Aleksei327/ESP32-C5-OBD2-Scanner/README.md

# ESP32-C5 OBD2 Scanner

[Русская версия](README.ru.md)

A DIY dual-CAN OBD2 diagnostic adapter built on the Seeed XIAO ESP32-C5, together with a read-only Android app. The first target is my own Citroën C3 II (2011, 1.4 KFT): ECU list, fault codes (read and clear), live data, freeze frames, a bus monitor and a PDF report. Other cars are added through a JSON knowledge base, without changing the firmware.

> **Status (November 2026): working, tested on the car.** Board v1 is built into its OBD2 enclosure, the firmware and app 0.1.5 are finished for the C3 II, and the whole chain has been used on the car: on 2 and 3 November full scans found 10 ECUs, fault codes were read with their texts, live data and an A/C test were recorded. Release: [v1.0](https://github.com/Aleksei327/ESP32-C5-OBD2-Scanner/releases/tag/v1.0).

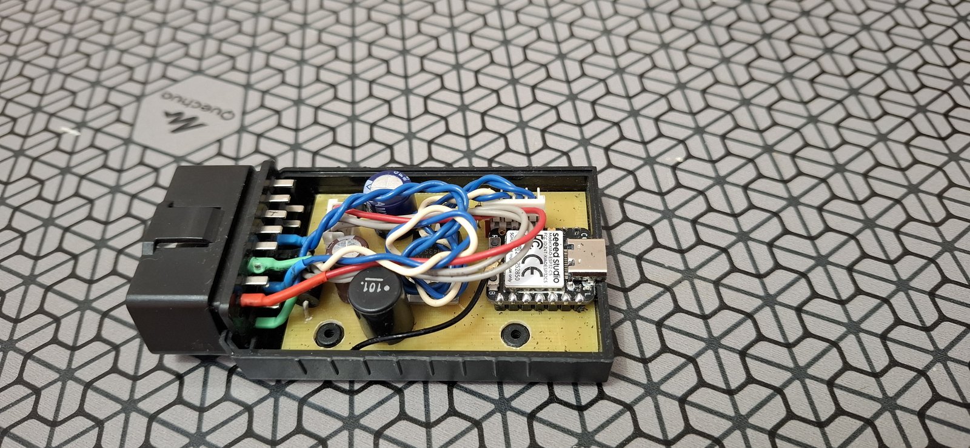
[picture p1: DOCS/images/photo-assembled.jpg]
The scanner in its OBD2 enclosure


## What works

- **Hardware:** single-sided 40 × 60 mm home-etched board in an OBD2 enclosure. Measured: on the car's OBD socket 13.4 V engine off and 14.4 V running; on the bench 4.95 V after the LM2596 and 4.83 V at the XIAO. The battery voltage reads within 0.05 V. Both CAN channels pass the self-test; the transmitters stay off in hardware until the firmware enables them.
- **Firmware** (ESP-IDF 6.1): Wi-Fi access point with its own password, WebSocket protocol, both CAN channels (OBD 6/14 and 3/8), ISO-TP with the PSA "response pending" handled, bus monitor, battery voltage, USB console with a self-test.
- **App 0.1.5** (Android): auto scan of every ECU in the knowledge base; ECU model recognised by part number; fault codes with texts from PSA-RE, the generic SAE list and, if built locally, the PSA code list in Russian and English; fault clearing; identification, live data, settings (read only); gauges, numbers and charts; bus monitor; PDF report. Scans are saved on the phone with a history (10 per car), a single module can be rescanned, and the garage and saved scans open without the adapter. The phone keeps its mobile internet while on the adapter's Wi-Fi.
- **Remote work:** a computer at home reaches the adapter at the car through the phone and a Cloudflare tunnel; `remote/scan.py` writes a full read-only scan to a report.
- **Simulator:** a C3 II in Python, to develop and test the app without the car.

Next: CAN-FD transceivers in board v2, and more cars through the knowledge base.

## The app

| | | |
| --- | --- | --- |
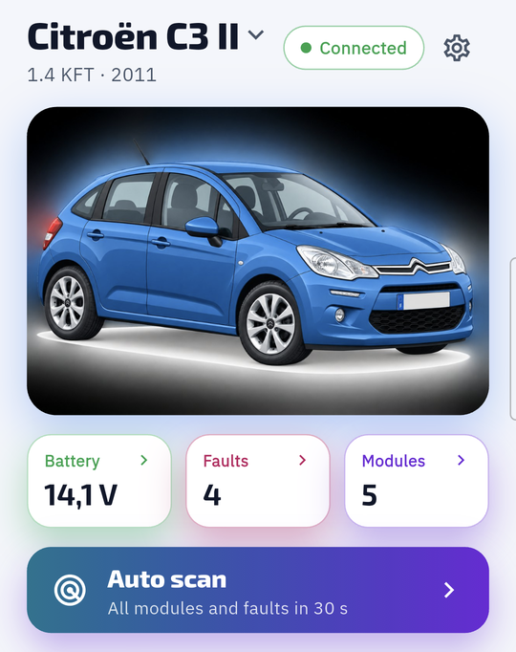
[picture p2: DOCS/images/app-car.png]
Car screen
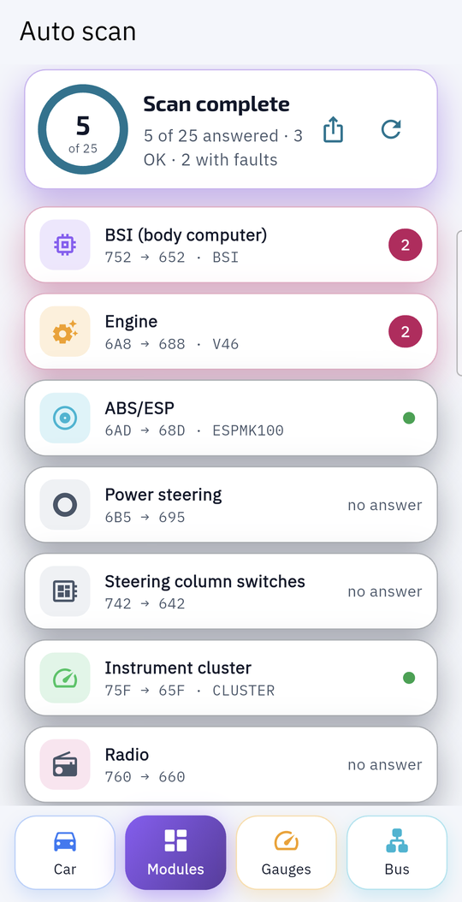
[picture p3: DOCS/images/app-scan.png]
Auto scan
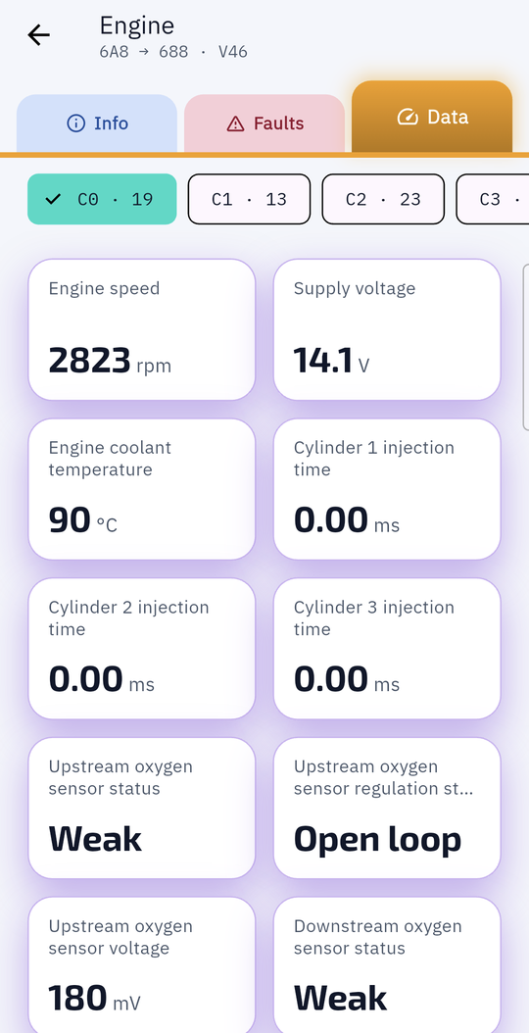
[picture p4: DOCS/images/app-live-data.png]
Engine live data
|  |  |  |
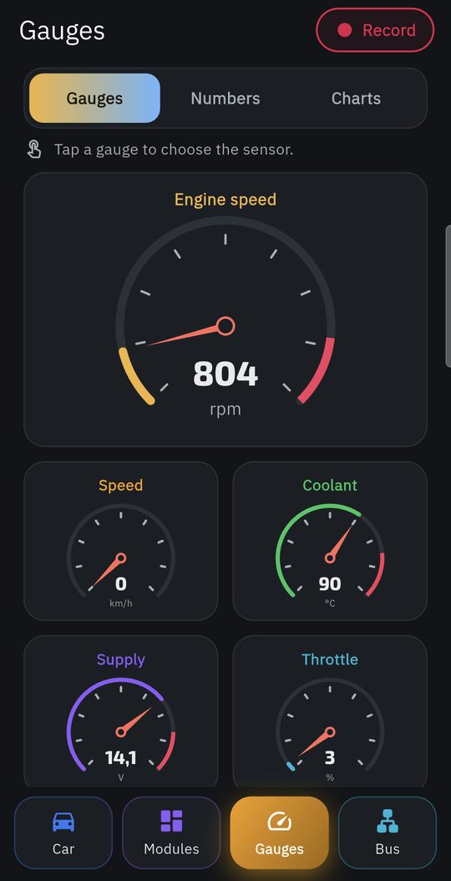
[picture p5: DOCS/images/app-gauges-dark.png]
Gauges, dark theme
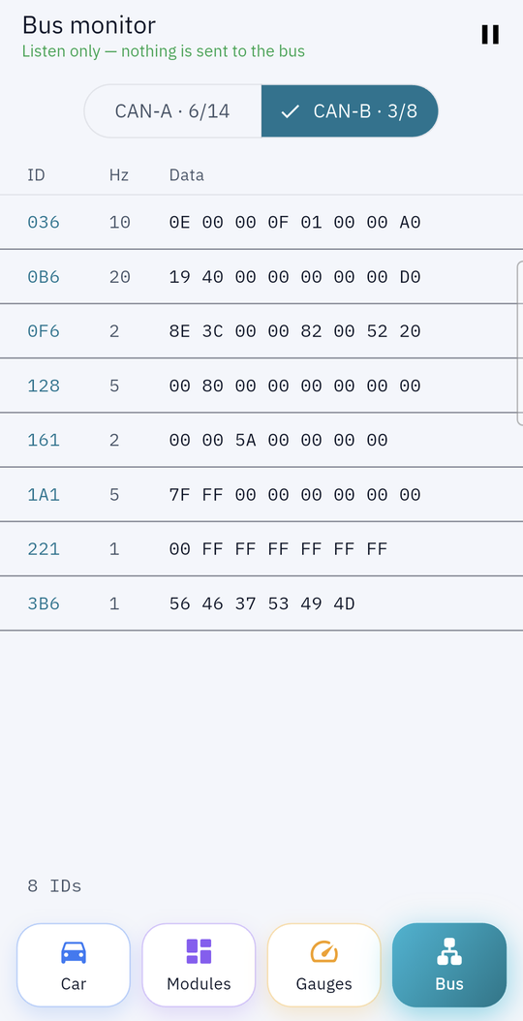
[picture p6: DOCS/images/app-bus-monitor.png]
Bus monitor
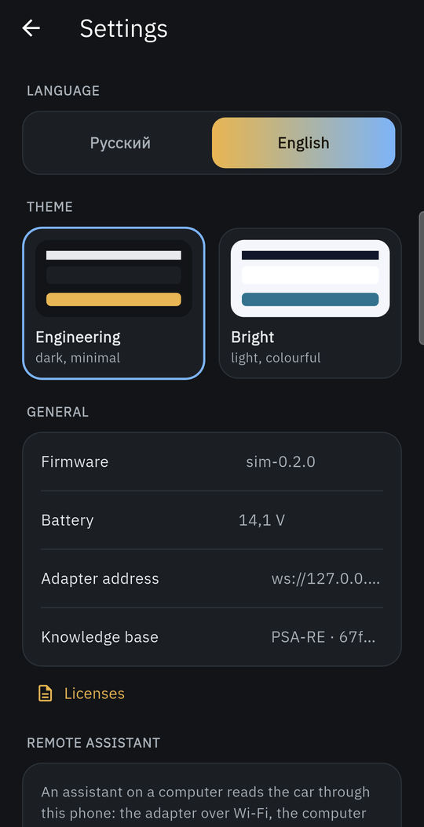
[picture p7: DOCS/images/app-settings-dark.png]
Settings, dark theme
|  |  |  |

App 0.1.3 in English. For these screenshots it is connected to the adapter simulator ([`sim/`](sim/README.md)), not to the car, so the ECUs and values are simulated.

## The board

| | | |
| --- | --- | --- |
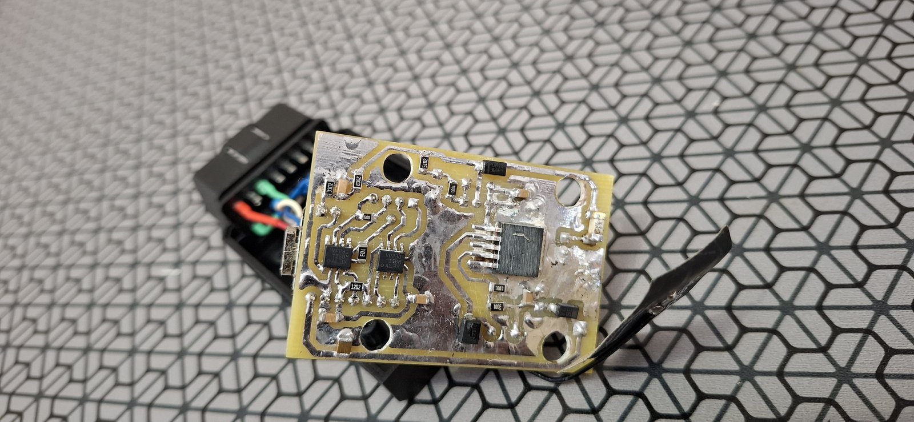
[picture p8: DOCS/images/photo-copper.jpg]
Copper side, home-etched and tinned
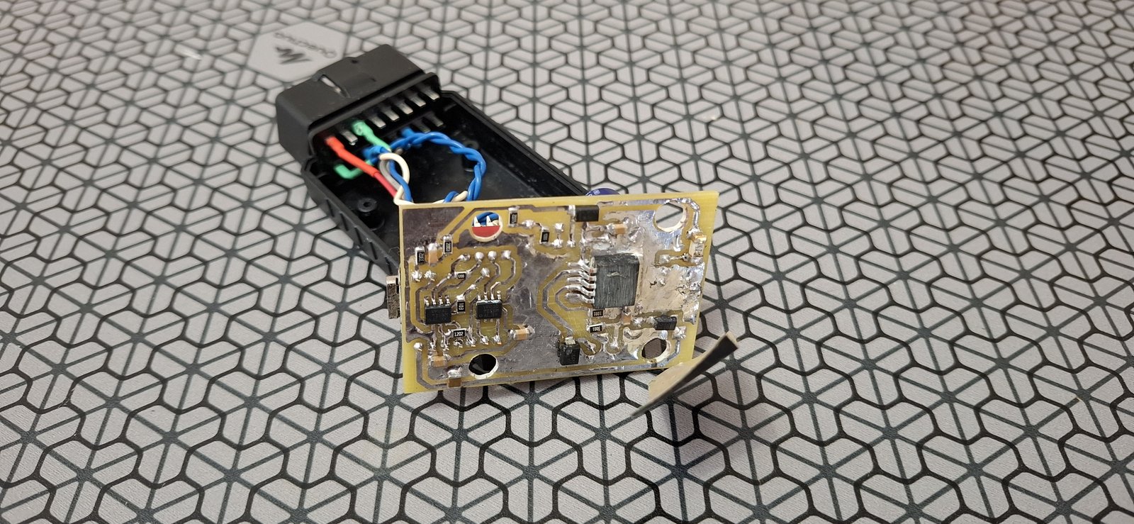
[picture p9: DOCS/images/photo-copper-angle.jpg]
Copper side at an angle
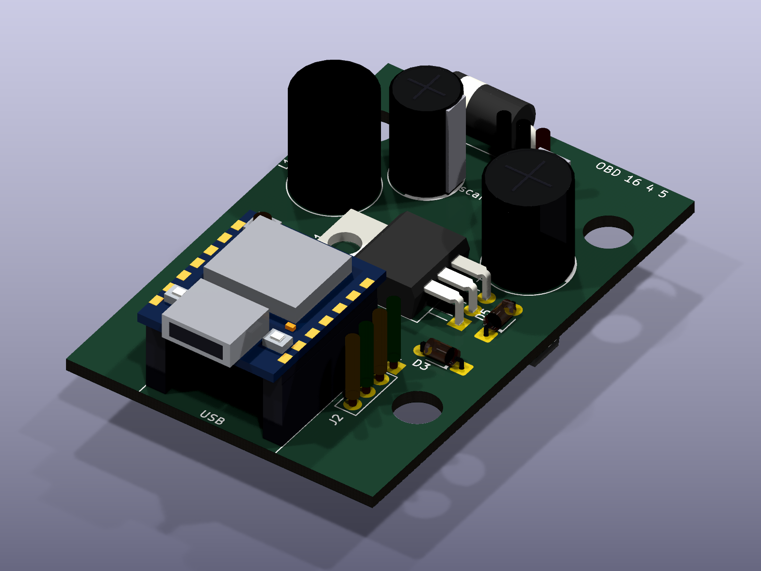
[picture p10: DOCS/images/board-3d-front.png]
Board v1, 3D view
|  |  |  |

The real board from the copper side (two SN65HVD230, the LM2596 and the SMD parts are on this side) and the KiCad 3D view of the component side. Schematic and layout: [`hardware/scaner_v1/`](hardware/scaner_v1/README.md).

## Key decisions

| What | Choice | Why |
| --- | --- | --- |
| MCU | Seeed XIAO ESP32-C5 | two CAN (TWAI) controllers, both CAN-FD capable; Wi-Fi 6 on 2.4 and 5 GHz; BLE; 8 MB PSRAM |
| CAN channel A | OBD 6/14 | legislated OBD-II (engine) |
| CAN channel B | OBD 3/8 | PSA Diag-on-CAN through the BSI, access to every ECU |
| Transceivers | 2 × SN65HVD230 (SOIC-8), desoldered from Waveshare modules | 3.3 V, enough for the C3; Rs on D9/D5 with pull-ups gives a hardware listen-only mode. CAN-FD transceivers in v2 |
| Power | OBD 16 → fuse → HS1M → IRFB4110 source follower (≤ 27 V) → LM2596S-ADJ (4.9 V) → SS34 (+ 1.5KE6.8CA TVS) → 3.3 V LDO on the XIAO | all from parts in stock; survives a 24 V jump start and surges up to 100 V |
| Hardware | own single-sided 40 × 60 mm board inside an OBD2 enclosure with a built-in connector; tracks on the bottom only, no jumpers | one dongle, no cables |
| App | Flutter for Android (Galaxy A55): read-only plus fault-code clearing; two themes; Russian and English | |
| Link | Wi-Fi, JSON over WebSocket; the adapter is a "dumb" transport, all logic lives in the app | a new car is a new JSON file |

## Repository

| Folder | Contents |
| --- | --- |
| [`hardware/scaner_v1/`](hardware/scaner_v1/README.md) | KiCad 10 project: schematic, PCB, footprints, 3D models, and the Python scripts that generate and route the board; PDF exports in `build/` |
| [`firmware/scaner_fw/`](firmware/scaner_fw/README.md) | ESP-IDF 6.1 adapter firmware: Wi-Fi access point and WebSocket server for the app, both CAN channels, battery voltage |
| [`app/`](app/README.md) | Flutter app |
| [`sim/`](sim/README.md) | Python simulator of the adapter with a C3 attached, to develop the app without hardware or a car |
| [`remote/`](remote/README.md) | remote assistant: a computer at home works with the adapter at the car through the phone and a Cloudflare tunnel |
| [`DOCS/en/`](DOCS/en/) | documentation in English ([`DOCS/`](DOCS/) — Russian originals) |

## Documentation

- [Board v1](DOCS/en/board-v1.md): block diagram, enclosure, OBD wiring, pin assignment, layout notes, first power-up
- [Input protection](DOCS/en/power-protection.md): what the car's electrical system does to pin 16 and how the board survives it
- [LM2596 DC-DC](DOCS/en/dc-dc-5v.md): parts and values
- [XIAO ESP32-C5](DOCS/en/xiao-esp32c5.md): pinout and which pins are used
- [SN65HVD230 transceiver](DOCS/en/can-sn65hvd230.md): wiring, listen-only mode, terminators
- [Adapter ↔ app protocol](DOCS/en/protocol.md)
- [Parts list](DOCS/en/parts-list.md)

PDF exports: [schematic](hardware/scaner_v1/build/scaner_v1.pdf), [placement and copper](hardware/scaner_v1/build/pcb_placement.pdf), [bottom copper 1:1 for etching](hardware/scaner_v1/build/pcb_bottom_cu.pdf).

## What is known about the C3 (PSA, AEE2004/2010 architecture)

- Full diagnostics run on pins **3/8** (Diag-on-CAN, 500 kbit/s) through the BSI. Pins **6/14** only give legislated engine OBD-II.
- Protocols: PSA-style KWP2000 (almost every ECU of the C3 II) and UDS, both over CAN (ISO-TP). The app finds out by itself which one an ECU speaks and recognises the ECU model by its part number.
- ECU addresses (request:response): BSI `752:652`, engine `6A8:688`, ABS/ESP `6AD:68D`, airbag `744:644`, instrument cluster `75F:65F`.
- On our C3 II 1.4 KFT the engine ECU is a Valeo V34 (KWP, session `81`). Answering: BSI, engine, ABS MK70, power steering, steering-column switches, instrument cluster, display, radio, airbag, seat-belt indicator and the battery sensor (the last one often answers "busy" or stays silent).
- Terminators: pins 6–14 already have both in the car (57 Ω), pins 3–8 only the BSI one (128 Ω), so the board has R8 fitted and R7 left out.

## Rules

1. The app only reads. The only write is clearing fault codes.
2. Airbag and ABS: read only. Emissions systems are not touched.
3. The adapter is not left in the car: pin 16 is powered from the battery at all times.

## Credits and third-party work

No third-party code is copied into this repository. The app's knowledge base is generated from PSA-RE data, with extra fault-code texts from ludwig-v and OBD Codes List (see below). These projects, tools and libraries were used or consulted:

- [prototux/PSA-RE](https://github.com/prototux/PSA-RE) (Apache-2.0) — PSA electronics reverse engineering: which ECUs the C3 II has, their addresses, protocols, part numbers, data records and fault-code texts. The app's knowledge base ([`app/assets/kb/`](app/assets/kb/)) is built from it by [`app/tool/build_kb.py`](app/tool/build_kb.py); its licence text ships with the data.
- [ludwig-v/arduino-psa-diag](https://github.com/ludwig-v/arduino-psa-diag) (GPL-3.0) — PSA ECU addresses ([ECU_LIST.md](https://github.com/ludwig-v/arduino-psa-diag/blob/master/ECU_LIST.md)) and KWP/UDS commands, used as a cross-check. Its fault-code lists fill the codes PSA-RE has no text for (mostly the BSI); they ship as a separate data file under GPL-3.0, [`app/assets/kb/c3_ii_dtc_gpl.json`](app/assets/kb/c3_ii_dtc_gpl.json), with the licence text next to it.
- [OBD Codes List](https://obdcodeslist.com/code-data.html) via [tekseport/obd2-codes](https://github.com/tekseport/obd2-codes) — generic SAE J2012 fault-code texts, shown when an ECU's own list has no text for a code. Code data from OBD Codes List, https://obdcodeslist.com/code-data.html
- [KiCad](https://www.kicad.org/) and its official symbol, footprint and 3D-model libraries.
- [Freerouting](https://github.com/freerouting/freerouting) — used to explore routing (`hardware/scaner_v1/tools/route.py`); the final layout is routed by hand.
- [ESP-IDF](https://github.com/espressif/esp-idf) (Espressif) — firmware framework; [Seeed Studio wiki](https://wiki.seeedstudio.com/xiao_esp32c5_getting_started/) — XIAO ESP32-C5 pinout.
- [Flutter](https://flutter.dev/) and the Dart packages listed in [`app/pubspec.yaml`](app/pubspec.yaml): web_socket_channel, flutter_svg, google_fonts, shared_preferences, intl, image_picker, path_provider, pdf, share_plus.
- Fonts [Exo 2](https://fonts.google.com/specimen/Exo+2) and [IBM Plex](https://github.com/IBM/plex), SIL Open Font License 1.1 (licence texts in `app/assets/google_fonts/`).
- [websockets](https://github.com/python-websockets/websockets) — the simulator's WebSocket server.
- Datasheets and application data: Texas Instruments (SN65HVD230, LM2596), Espressif (ESP32-C5), Waveshare (SN65HVD230 CAN Board schematic).

Each of these keeps its own licence.

## License

See [NOTICE.md](NOTICE.md) and [LICENSE](LICENSE) (CC BY-NC-ND 4.0, with permission to build one unit for yourself).
