Aleksei327/ESP32-C5-OBD2-Scanner/DOCS/ПЛАТА_v1.md

# Плата v1

**Цель:** первая своя плата, на которой собрано всё, внутри корпуса OBD2 с разъёмом. Подключаем её к C3, читаем стандартный OBD-II (канал A) и опознаём BSI через Diag-on-CAN (канал B).

[English version](en/board-v1.md)

Компоненты: [плата XIAO ESP32-C5](ESP32-C5_ПЛАТА.md), [трансивер SN65HVD230](CAN_SN65HVD230.md), [DC-DC на LM2596](DC-DC_5V.md), [защита питания](ЗАЩИТА_ПИТАНИЯ.md). KiCad-проект — [hardware/scaner_v1](../hardware/scaner_v1/).

## Блок-схема

```text
OBD 16 ─► предохранитель ─► HS1M ─► повторитель IRFB4110 (≤ 27 В) ─► LM2596S-ADJ (4,9 В) ─► SS34 ─► 5V (TVS 1.5KE6.8CA) ─► плата XIAO ESP32-C5 (LDO) ─► 3,3 В ─► VCC трансиверов
OBD 6/14 ─► SN65HVD230 (A) ◄─► D8 (GPIO8) D, D7 (GPIO12) R, D9 (GPIO9) Rs
OBD 3/8  ─► SN65HVD230 (B) ◄─► D1 (GPIO0) D, D10 (GPIO10) R, D5 (GPIO24) Rs
OBD 4, 5 ─► GND
```

Микросхемы SN65HVD230 выпаиваем с модулей Waveshare и ставим прямо на плату. XIAO — на гнёзда (модуль на ~10 мм над платой), а если по высоте не влезет, впаять напрямую. Защита питания и DC-DC собираются на плате.

## Корпус и размеры

Корпус OBD2 с встроенным разъёмом (AliExpress, ~10 €). По фото продавца: снаружи 72 × 45 мм, внутри шириной 42 мм, четыре стойки под винты 35 × 40 мм между центрами.

- Плата 40 × 60 мм, как собрана, подогнана по настоящему корпусу: четыре отверстия Ø5,5 мм над стойками под винты, между центрами 30,8 мм поперёк и 35,6 мм вдоль; первая пара в 9,55 мм от края у разъёма.
- Плата односторонняя, как в БП: нижняя медь — травленые дорожки, верхняя — перемычки из провода.
- От выводов разъёма к площадкам — проводки (нужны только 3, 4, 5, 6, 8, 14, 16). Питание (16, 4, 5) идёт на J1 у предохранителя, а обе пары CAN — на J2 у трансиверов: 14, 6, 8, 3 (провода по 4–5 см, пары лучше свить). Так через плату не тянется шина из четырёх дорожек.
- IRFB4110 (TO-220) лежит теплоотводом вниз над LM2596, без винта. TVS 1.5KE (DO-201AD, шаг 12,7 мм) и стеклянные стабилитроны (DO-35, корпус 3,5 × 1,9 мм, шаг 5,08 мм) — лёжа. Электролиты (C1 10 мм, C3 8 мм, оба высотой 12,3 мм) стоят: они не выше XIAO на гнёздах (~13 мм). C1 — впритык к стойке корпуса Ø8, зазор ~0,5 мм.
- XIAO стоит USB-разъёмом к дальнему торцу: можно прорезать окно в корпусе для прошивки без разборки.

> ⚠ Размеры взяты с фото продавца. Когда корпус придёт, обмерить: внутреннюю длину от разъёма до торца, положение стоек относительно разъёма, высоту внутри. Обвод платы и отверстия поправим под факт.

## Разъём OBD-II

| Пин OBD | Сигнал | Площадка |
| --- | --- | --- |
| 16 | +12 В от АКБ (есть всегда, даже без зажигания) | J1.1 |
| 4 | масса кузова | J1.2 |
| 5 | сигнальная масса | J1.3 |
| 14 | CAN-L, стандартный OBD-II (канал A) | J2.1 |
| 6 | CAN-H, стандартный OBD-II (канал A) | J2.2 |
| 8 | Diag CAN-L, PSA (канал B) | J2.3 |
| 3 | Diag CAN-H, PSA (канал B) | J2.4 |

На шелкографии подписано: «OBD 16 4 5» справа от J1 (слева направо) и номер вывода OBD под каждым пятаком J2: 14, 6, 8, 3.

Остальные пины не подключаем. После пайки всё прозвонить тестером: на штекере нумерация зеркальна гнезду машины.

## Питание

OBD 16 → предохранитель T2A (SMD Nano², снизу у J1) → HS1M → повторитель на IRFB4110 (на выходе не больше ~27 В) → 100 мкФ / 63 В → LM2596S-ADJ (4,9 В) → SS34 → линия 5V (на ней TVS 1.5KE6.8CA) → плата XIAO ESP32-C5. Её стабилизатор даёт 3,3 В, от них же питаются трансиверы. Подробно — в [ЗАЩИТА_ПИТАНИЯ](ЗАЩИТА_ПИТАНИЯ.md) и [DC-DC_5V](DC-DC_5V.md).

**SS34 на выходе DC-DC** развязывает его с USB. На линии 5V остаётся ~4,6 В, чуть ниже, чем даёт USB: если воткнуть ноутбук, плата питается от него, и в ноутбук ничего не идёт.

Места под TVS 1.5KE27A на входе в v1 нет: вход держит повторитель на IRFB4110 (до 100 В). Он обязателен — перемычки в обход него на плате нет.

## Напряжение АКБ

```text
после HS1M ──[200 кОм]──┬──► D0 (АЦП)
                        ├──[33 кОм]──► GND
                        └──[100 нФ]──► GND
```

Делитель стоит до ограничителя, чтобы мерить настоящее напряжение АКБ. На входе АЦП: 12 В → ~1,6 В, 14,4 В → ~1,9 В, 18 В → ~2,4 В. Падение на HS1M (~1 В) учтём в прошивке. Если на D0 почти 0, значит, машины нет и плата питается от USB.

## Выводы XIAO ESP32-C5

| Сигнал | Ножка |
| --- | --- |
| CAN-A: D / R / Rs | D8 (GPIO8) / D7 (GPIO12) / D9 (GPIO9) |
| CAN-B: D / R / Rs | D1 (GPIO0) / D10 (GPIO10) / D5 (GPIO24) |
| Напряжение АКБ | D0 (GPIO1, АЦП) |
| Светодиод | GPIO27 (на плате XIAO) |
| Свободна | D4 (GPIO23) |
| Не занимаем | D2 (GPIO25) и D3 (GPIO7) — strapping; D6 (GPIO11, при загрузке туда идёт лог) |

Ножки выбраны под разводку на одной стороне. D7 — это RX UART0, но консоль у нас по USB, так что UART0 свободен. Подключение трансиверов, подтяжки и терминаторы описаны в [CAN_SN65HVD230](CAN_SN65HVD230.md).

## Разводка

Плата односторонняя, все дорожки снизу, **перемычек нет**. Земля — сплошная заливка снизу, к площадкам прилегает сплошь (без термобарьеров), от чужой меди отступает на 1 мм и нигде не уже 1 мм.

- Дорожки: сигналы 0,8 мм, питание 1,2 мм, SW 1,0 мм. Зазор 0,4 мм. Питание и земля трансиверов проходят под корпусом SOIC-8 между рядами ножек (0,8 мм).
- Площадки SN65HVD230 — 0,8 мм шириной, как и дорожки к ним (зазор между соседними ~0,47 мм).
- Пятаки выводных деталей и гнёзд XIAO — 2,0 мм. Все отверстия под выводы — засверловка 0,6 мм, дальше рассверливаешь под ногу. Крепёжные — 3,2 мм под M3.
- Дроссель L1 — выводной Ø10 × 13,5 мм (шаг 5, в ферритовом чулке), стоит сверху на месте прежнего SMD 12×12. Чулок — экран, поэтому земля под ним снизу разрешена.
- Земля питания (LM2596, вход) и земля трансиверов/XIAO связаны дорожкой 0,8 мм: между ножками D7 (у него площадки укорочены до 2 мм, между ними 2,5 мм), вниз слева мимо дросселя и полосой под линией SW до стабилитрона D3 — заливка с зазором 1 мм в эти места не пролезает.
- Трансивер канала B (U3) стоит снизу под XIAO, между рядами гнёзд. Сверху там ничего нет.
- Расстановка — `tools/gen_pcb.py`, дорожки — список точек в `tools/routes.py`, кладёт их `tools/hand_route.py` (заливает землю и гоняет DRC). Порядок: `gen_schematic.py` → `check_netlist.py` → `gen_pcb.py` → `hand_route.py`.
- 3D: всё, чего нет в библиотеке KiCad (XIAO на гнёздах, дроссель 10 × 13,5, электролиты в живой высоте 12,3, стабилитроны DO-35 с шагом 5,08, провода OBD на J1/J2), рисует `tools/gen_3d.py` в `scaner.3dshapes/`. Посмотреть — в KiCad Alt+3 или `kicad-cli pcb render`.

## Терминаторы R7/R8: паять по замеру

Перемычек у терминаторов нет: впаял резистор — терминатор включён, не впаял — выключен. По умолчанию их не ставим: в схеме и на плате R7/R8 помечены DNP (KiCad их перечёркивает), а на плате ещё и обведены на отдельном слое «Не ставить (DNP)». Шина CAN в машине уже закрыта резисторами 120 Ом на двух дальних концах, а гнездо OBD — отвод от неё, поэтому прибору свой терминатор обычно не нужен. Лишний 120 Ом на шине с 60 Ом даёт 40 Ом и нагружает передатчики всех блоков машины.

Зажигание выключено, машина закрыта и «уснула» (5–10 минут). Мультиметр в режиме сопротивления, щупы в гнездо OBD машины:

| Пины | Ожидаем | Что значит |
| --- | --- | --- |
| 6–14 | ~60 Ом | оба терминатора шины на месте, R7 не паять |
| 3–8 | ~60 или ~120 Ом | 60 → R8 не паять; 120 → BSI ждёт второй конец линии от прибора, паять R8 |

Результаты замеров (Citroën C3 II, 2026-10-31):

- 6–14: 57 Ом — R7 не паяем
- 3–8: 128 Ом — стоит только терминатор BSI: диагностическая CAN идёт напрямую от BSI к гнезду, R8 впаян

## Стенд без машины

Роль машины играет STM32 со встроенным CAN и третьим модулем Waveshare целиком (на нём R2 оставляем). Соединяем проводами с каналом A или B нашей платы и ставим второй терминатор: выводной резистор 120 Ом между проводами H и L. Получаются два конца шины, 60 Ом. Можно обойтись и без стенда: самотест между каналами A и B плюс сама машина.

## Порядок первого запуска

1. **Питание без XIAO.** Подать 12 В от регулируемого блока питания с ограничением тока. Проверить ~4,9 В на выходе LM2596 и ~4,6 В на линии 5V. Потом плавно поднять вход до 35–40 В: на выходе повторителя должно остаться не больше ~27 В, а транзистор только тёплый.
2. **Самотест по USB, без машины.** Соединить каналы A и B между собой (CANH–CANH, CANL–CANL) и повесить между H и L выводной резистор 120 Ом: на коротких проводах одного хватает, R7/R8 ради этого паять не надо. Прошивка самотеста гоняет кадры между каналами.
3. **Замер терминаторов на машине** (см. выше).
4. **В машине, режим «только слушать».** Включить зажигание. Выводы Rs остаются в 1 (подтяжка), трансиверы физически не передают, а контроллеры CAN вдобавок в режиме listen-only. Смотрим трафик на обоих каналах.
5. **Первые запросы.** Стандартные OBD-II на канале A: обороты, температура и VIN, если машина его отдаёт. Идентификация BSI (`752:652`) на канале B.

## Пока не делаем

- В блоки ничего не пишем: приложение только читает, из записи — только сброс ошибок.
- Не оставляем адаптер в машине на ночь, пока нет режима сна.
