Aleksei327/ESP32-C5-OBD2-Scanner/DOCS/CAN_SN65HVD230.md

# Трансивер CAN SN65HVD230

[English version](en/can-sn65hvd230.md)

Трансивер переводит сигналы ESP32 (логика 3,3 В) в дифференциальную шину машины CAN-H/CAN-L и обратно. Сам протокол обрабатывает контроллер CAN внутри ESP32-C5.

Покупаем модули Waveshare SN65HVD230 CAN Board ([Gotronic](https://www.gotronic.fr/art-module-sn65hvd230-can-48593.htm), код 3945), **выпаиваем с них микросхемы (SOIC-8) феном и ставим на нашу плату**. Так плата компактнее, и вывод Rs становится доступен: получается аппаратный режим «только слушать».

## Характеристики (по данным TI)

- Питание 3,3 В (3–3,6 В), подключается к ESP32 напрямую.
- Скорость до 1 Мбит/с, только обычный CAN. Для C3 (500 кбит/с) этого хватает.
- Выводы шины держат от −4 до 16 В и статику больше ±16 кВ (HBM).
- Вывод Rs: 1 — «только слушать» (передатчик выключен, приёмник работает, ~370 мкА), 0 — обычная работа на полной скорости.

## Модуль Waveshare (для справки)

По схеме Waveshare и фото платы:

- гребёнка на 4 контакта: 1 — CAN_TX, 2 — CAN_RX, 3 — GND, 4 — 3.3V (на шелкографии сверху вниз: 3.3V, GND, CAN RX, CAN TX);
- CANL и CANH — на двух штырях и винтовой клемме с другой стороны;
- терминатор R2 120 Ом впаян намертво, Rs посажен на землю через 10 кОм (R1).

С нашей платой модуль целиком нужен только для стенда на STM32.

## Микросхема на плате (SOIC-8)

| Вывод | Что это | Канал A (U2) | Канал B (U3) |
| --- | --- | --- | --- |
| 1 D | данные на передачу | D8 (GPIO8) | D1 (GPIO0) |
| 2 GND | масса | GND | GND |
| 3 VCC | питание 3,3 В | 3V3 | 3V3 |
| 4 R | принятые данные | D7 (GPIO12) | D10 (GPIO10) |
| 5 Vref | опорное VCC/2 | не подключаем | не подключаем |
| 6 CANL | шина CAN-L | OBD 14 | OBD 8 |
| 7 CANH | шина CAN-H | OBD 6 | OBD 3 |
| 8 Rs | режим | D9 (GPIO9) | D5 (GPIO24) |

- **Rs подтянут к 3,3 В** резистором 10–12 кОм (R11, R12). Пока ESP32 загружается или перепрошивается, трансиверы физически не могут ничего отправить в машину. Прошивка сама опускает Rs в 0, когда пора передавать.
- Подтяжки на D не ставим: пока Rs = 1, передатчик выключен, что бы ни было на D. Прошивка сначала запускает контроллер CAN (D = 1, «тишина»), и только потом опускает Rs.
- 100 нФ на VCC у самого вывода (C6, C7).
- **Терминатор** 120 Ом на каждом канале (R7, R8) стоит прямо между H и L, без перемычки: по умолчанию не ставим (DNP), паять или нет, решает замер на машине (см. [ПЛАТА_v1](ПЛАТА_v1.md)). На C3 II: R7 не ставим (6–14 = 57 Ом), R8 впаян (3–8 = 128 Ом).

## Когда понадобится CAN-FD

Для самых новых машин нужен трансивер с FD, например TCAN3413/TCAN3414 (шина ±58 В, но выводы другие) или TJA1051T/3. Это задача для v2.

## Источники

- [SN65HVD230 (TI)](https://www.ti.com/product/SN65HVD230)
- [Waveshare: SN65HVD230 CAN Board](https://www.waveshare.com/wiki/SN65HVD230_CAN_Board), [схема модуля](https://files.waveshare.com/upload/c/c5/SN65HVD230-CAN-Board-Schematic.pdf)
