Aleksei327/ESP32-C5-OBD2-Scanner/DOCS/DC-DC_5V.md

# DC-DC на LM2596S-ADJ → 4,9 В

[English version](en/dc-dc-5v.md)

Собираем прямо на плате из запасов. Вход — после [повторителя-ограничителя](ЗАЩИТА_ПИТАНИЯ.md), то есть не больше ~27 В, а LM2596 держит до 40 В. Выход через диод SS34 идёт на вывод 5V платы XIAO ESP32-C5, где её стабилизатор делает 3,3 В для ESP32 и трансиверов.

## Обвязка

| Элемент | Номинал | Примечание |
| --- | --- | --- |
| LM2596S-ADJ | корпус TO-263 | из запасов |
| R3 (выход → FB) | 3,0 кОм | Uвых = 1,23 × (1 + R3/R4) = 1,23 × 4 = **4,92 В** |
| R4 (FB → GND) | 1 кОм | по даташиту нижний резистор берут от 1 до 5 кОм |
| Дроссель | 100 мкГн (маркировка 101), выводной в ферритовом чулке, Ø10 × 13,5 мм, шаг 5, провод 0,3–0,35 мм | из запасов. Ток у нас ~0,2 А, пики ~0,4 А — хватает. Стоит сверху, самая высокая деталь: до крышки ~1,7 мм |
| Диод | SS34 (40 В, 3 А) | на узел SW приходит не больше ~27 В |
| Cвх | 100 мкФ / 63 В (банка 10 × 12,3 мм, шаг 5 мм, ESR 0,13 Ом) + 100 нФ | общий с выходом повторителя |
| Cвых | 220 мкФ / 25 В, low ESR (банка 8 × 12,3 мм, шаг 3,5 мм, ESR 0,13 Ом) + 100 нФ | полимерный или одна керамика не годятся: при ESR ниже ~0,05 Ом LM2596 может возбудиться |
| ON/OFF (вывод 5) | на GND | стабилизатор всегда включён |
| Диод развязки | SS34 | с выхода на вывод 5V платы XIAO |
| TVS | 1.5KE6.8CA | на линии 5V у XIAO, см. ниже |

**Почему 4,9 В, а не ровно 5.** После диода развязки на вывод 5V платы XIAO приходит ~4,6 В, то есть чуть меньше, чем даёт USB (5 В). Вывод 5V у XIAO — это линия USB, и есть ли на ней свой диод, по вики Seeed не понятно. Если воткнуть ноутбук при питании от машины, плата возьмёт питание от USB, а в ноутбук ничего не пойдёт. Стабилизатору 3,3 В на XIAO 4,6 В хватает с запасом.

**Зачем диод развязки.** Когда плата питается от USB ноутбука, он не даёт напряжению уйти обратно в LM2596.

**TVS 1.5KE6.8CA на линии 5V.** До 5,8 В он не проводит, поэтому в работе спит. Если LM2596 пробьёт и на выход проскочит входное напряжение, TVS его ограничит, ток резко вырастет и сгорит входной предохранитель. XIAO и модули CAN останутся целы. Заодно ловит статику со стороны USB.

Пока в прошивке нет режима сна, адаптер в машине не оставляем: ESP32 с Wi-Fi берёт заметно больше, чем сам DC-DC.
