Aleksei327/ESP32-C5-OBD2-Scanner/firmware/README.md

# Прошивка

## scaner_fw — прошивка адаптера

Точка Wi-Fi `SCANER-C5-XXXX` и сервер WebSocket `ws://192.168.4.1:81/ws` для приложения, две шины CAN, замер напряжения АКБ. Протокол — [DOCS/ПРОТОКОЛ.md](../DOCS/ПРОТОКОЛ.md). Подробно — [scaner_fw/README.ru.md](scaner_fw/README.ru.md).

Консоль работает по USB-разъёму XIAO:

| Команда | Что делает |
| --- | --- |
| `status` | состояние шин, Wi-Fi и АКБ |
| `wifi` / `wifi pass <пароль>` | имя сети и пароль / сменить пароль |
| `selftest` | каналы A и B соединены проводами (CANH–CANH, CANL–CANL), между H и L выводной резистор 120 Ом; каждый канал шлёт другому 20 кадров |
| `listen [секунды]` | слушает оба канала и печатает кадры. Трансиверы в режиме «только слушать» (Rs = 1), контроллеры CAN в listen-only: в машину не уходит ничего |
| `vbat` | напряжение АКБ (пин 16 OBD) |

При включении обе шины закрыты, трансиверы в «только слушать». Передавать адаптер начинает, только когда приложение откроет шину с `listen: false`; когда приложение отключается, он закрывает шины сам.

## Сборка

Нужен ESP-IDF 6.1 (ESP32-C5 поддерживается начиная с 5.5). В VS Code — расширение ESP-IDF от Espressif, в нём указать уже установленный ESP-IDF.

> ⚠ Путь к проекту — только латиница и без пробелов: с кириллицей (например, «Документы») ESP-IDF и компилятор GCC не работают. Поэтому проект лежит в `D:\scaner-auto`. На этом компьютере ESP-IDF стоит в `D:\esp\v6.1\esp-idf`, инструменты — в `D:\esp\.espressif`.

```text
idf.py set-target esp32c5
idf.py build
idf.py -p COMx flash monitor
```

## Лицензия

Пока прошивка не содержит чужого кода и распространяется на условиях [NOTICE.md](../NOTICE.md). Если в неё войдёт код под GPL-3.0, эта часть будет распространяться под GPL-3.0.
