Aleksei327/ESP32-C5-OBD2-Scanner/DOCS/ЗАЩИТА_ПИТАНИЯ.md

# Защита питания от бортсети

[English version](en/power-protection.md)

## Что бывает на пине 16

На пине 16 разъёма OBD всегда есть +12 В от АКБ, но чистым это напряжение не назовёшь:

| Что | Сколько длится | Чем опасно |
| --- | --- | --- |
| Иголки при коммутации нагрузок, статика при втыкании | микросекунды | пробой чипов |
| Отрицательные иглы при отключении индуктивных нагрузок | микросекунды | до −100 В |
| Сброс нагрузки (отпала клемма при работающем генераторе) | сотни миллисекунд | ~35 В в современных машинах, до ~100 В в старых |
| Прикуривание от 24 В | минуты | двойное напряжение |
| Прокрутка стартером | доли секунды | провал до 6–8 В |
| Переполюсовка | — | в машине не бывает, а вот при пайке и опытах на столе — запросто |

## Схема

Вместо TVS — линейный ограничитель на транзисторе (истоковый повторитель). Он пропускает обычное напряжение, а всё, что выше ~27 В, берёт на себя. За ним стоит DC-DC на LM2596S-ADJ (см. [DC-DC_5V](DC-DC_5V.md)).

```text
OBD 16 ─► предохранитель T2A ─► HS1M ─► повторитель IRFB4110 (на выходе ≤ ~27 В) ─► LM2596S-ADJ ─► 4,9 В
```

| Элемент | Куда подключён | Зачем |
| --- | --- | --- |
| Предохранитель T2A, SMD Nano² 2410 (из запаса) | OBD 16 → HS1M | последний рубеж: если что-то внутри пробьёт накоротко, сгорит он, а не предохранитель в блоке машины |
| Диод HS1M (1000 В, 1 А) | анод к предохранителю, катод к стоку IRFB4110 | переполюсовка и отрицательные иглы |
| IRFB4110 (100 В) | сток — после HS1M, исток — вход LM2596 | повторитель: пропускает, но на выходе не больше ~27 В |
| Резистор 51 кОм (годится и 47 кОм), корпус 1206 | от стока к узлу опоры затвора | подпитка затвора. 1206 — потому что на нём бывают десятки вольт |
| Стабилитрон 30 В (стекло DO-35) | от узла опоры на GND, катодом к опоре | порог 30 В: на выходе получается 30 − ~3,5 = ~26,5 В. У 30-вольтовых разброс 28–32 В, так что на выходе 24,5–28,5 В |
| Резистор 100 Ом | узел опоры → затвор | чтобы повторитель не возбудился |
| Стабилитрон 12 В (стекло DO-35) | затвор–исток, катод к затвору | у IRFB4110 предел затвор–исток ±20 В, а при включении, пока конденсаторы пустые, на затворе уже 30 В. В работе между затвором и истоком ~3,5–5 В, стабилитрон спит |
| 100 мкФ / 63 В + 100 нФ | исток → GND | вход LM2596 |

Заодно получается мягкий старт: затвор заряжается через 51 кОм примерно за миллисекунду, и бросок тока на конденсаторы маленький.

## Что происходит в разных ситуациях

| Ситуация | Что происходит |
| --- | --- |
| Обычная работа, 12–14,8 В | транзистор открыт; на выходе на ~4,5 В меньше входа (~1 В на HS1M, ~3,5 В на транзисторе), потери около 0,3 Вт |
| Прокрутка стартером | напряжение проседает, адаптер, скорее всего, перезагрузится. Для сканера не страшно |
| Прикуривание от 24 В | проходит как есть (~19 В на выходе), всё работает |
| Сброс нагрузки ~35 В | на выходе ~26,5 В, транзистор греется на ~0,5 Вт |
| Выброс до 100 В | на выходе ~26,5 В, транзистор ~5 Вт на доли секунды. Сток–исток видит ~73 В из 100 допустимых |
| Отрицательные иглы, переполюсовка | HS1M закрыт, держит 1000 В |

Радиатор не нужен: TO-220 переживает такие короткие нагрузки сам.

## TVS

На входе не нужен: длинные выбросы режет повторитель, отрицательные держит HS1M. Места под TVS на входе в v1 нет.

На линии 5V после DC-DC стоит 1.5KE6.8CA — страховка на случай, если пробьёт LM2596 (см. [DC-DC_5V](DC-DC_5V.md)).

## Проверка на столе

Перед машиной проверить на регулируемом блоке питания с ограничением тока: плавно поднять вход до 35–40 В и убедиться, что на выходе повторителя не больше ~27 В (с учётом разброса стабилитрона на 30 В — до 28,5 В), а транзистор только тёплый.
