Aleksei327/ESP32-C5-OBD2-Scanner/DOCS/ПОКУПКИ.md

# Список покупок

[English version](en/parts-list.md)

## Берём

| Что | Где | Сколько | ≈ € |
| --- | --- | --- | --- |
| Модуль CAN SN65HVD230 (Waveshare) — с него выпаиваем микросхему | [Gotronic](https://www.gotronic.fr/art-module-sn65hvd230-can-48593.htm) | 2 | 9,50 |
| Плата Seeed XIAO ESP32-C5 (код 100010048) | [Gotronic](https://www.gotronic.fr/art-carte-xiao-esp32-c5-100010048-49303.htm) | 1 | 6,90 |
| Доставка Gotronic «Lettre suivie», около 4 дней | | | 2,90 |
| Корпус OBD2 со встроенным разъёмом (72 × 45 мм) | AliExpress | 1 | ~10 + 3 € пошлины |

**Итого: ~32 €** (Gotronic 19,30 € с доставкой + корпус ~13 €).

Когда корпус придёт: проверить, что в разъёме есть контакты 3, 4, 5, 6, 8, 14, 16, и обмерить его внутри (см. [ПЛАТА_v1](ПЛАТА_v1.md), раздел «Корпус и размеры»).

## Из запасов

**Питание** (см. [ЗАЩИТА_ПИТАНИЯ](ЗАЩИТА_ПИТАНИЯ.md) и [DC-DC_5V](DC-DC_5V.md)):

- предохранитель SMD Littelfuse Nano² (2410) T2A — из запаса;
- HS1M;
- IRFB4110;
- стабилитроны (стекло DO-35): 30 В и 12 В — по 1 шт., есть в запасе;
- резисторы 47–51 кОм (1206), 100 Ом, 1 кОм, 3,0 кОм;
- LM2596S-ADJ и дроссель 100 мкГн (маркировка 101, выводной Ø10 × 13,5 мм в ферритовом чулке) — есть;
- SS34 — 2 шт.;
- TVS 1.5KE6.8CA (на линию 5V);
- конденсаторы 100 мкФ / 63 В и 220 мкФ / 25 В low ESR (оба есть, 10 × 12,3 и 8 × 12,3 мм), 100 нФ, 10 мкФ.

**Делитель напряжения АКБ:** 200 кОм (1206), 33 кОм, 100 нФ (если верхний резистор другой — поправить VBAT_DIVIDER в прошивке).

**CAN:** резисторы 10–12 кОм — 2 шт. (подтяжки Rs), 120 Ом — 2 шт. (терминаторы), 100 нФ — 2 шт. Все резисторы и конденсаторы — 1206.

**Прочее:** гребёнки PLS/PBS под XIAO, провод для перемычек от разъёма к плате.

## Проверить, есть ли дома

- Регулируемый блок питания с ограничением тока: им проверяем ограничитель до 35–40 В.
- Кабель USB-C с передачей данных, а не только зарядный.

## Не берём

- Отдельную вилку OBD — разъём встроен в корпус.
- Модуль DC-DC и лот TVS — свой DC-DC на LM2596, а TVS с повторителем не нужен.
- NUP2105L — своей защиты SN65HVD230 хватает.
- Третий модуль SN65HVD230 для стенда — только если понадобится стенд (~5 € на Gotronic).
- TJA1051T/3, TPS26600, KONNWEI KW906, ESP32-C3 SuperMini, ESP32-C6, MCP2562FD, гнездо OBD «мама», макетки и провода Dupont, L9637D, DIP-переключатель, Y-тройник.
