Aleksei327/ESP32-C5-OBD2-Scanner/app/assets/img/car_c3.jpg

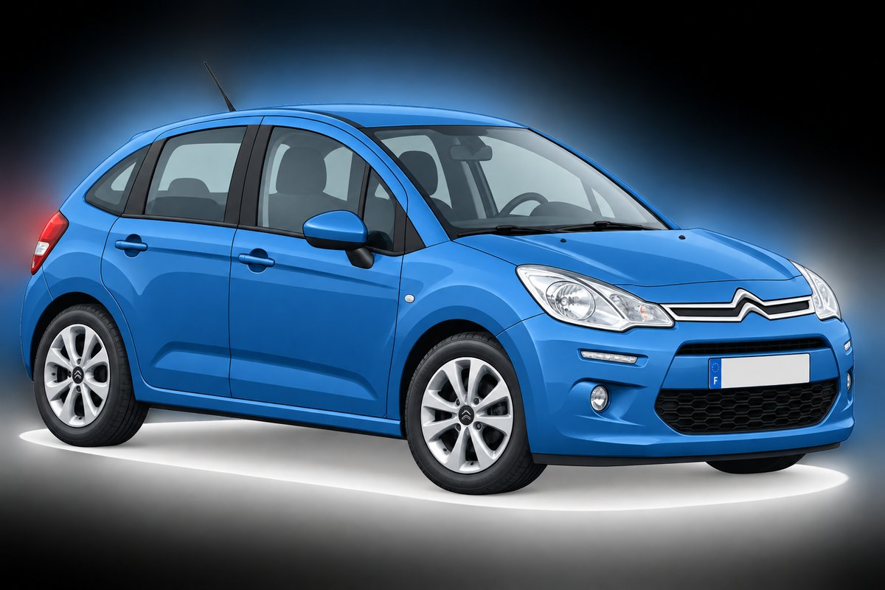
app/assets/img/car_c3.jpg
