Aleksei327/ESP32-C5-OBD2-Scanner/DOCS/images/board-3d-rear.png

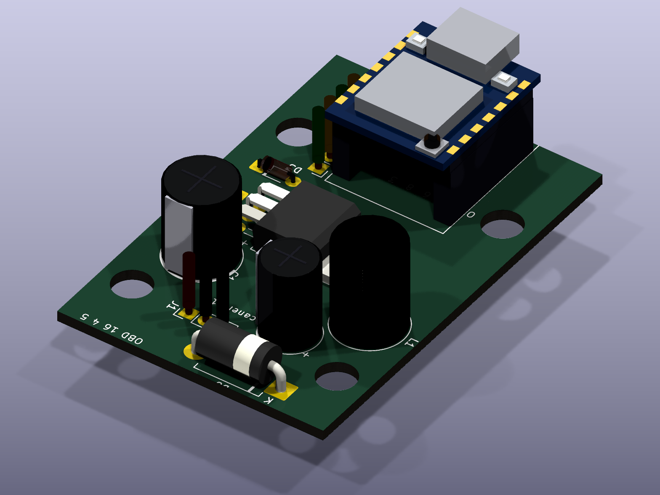
DOCS/images/board-3d-rear.png
