Aleksei327/ESP32-C5-OBD2-Scanner/hardware/scaner_v1/case/board_in_case_side.png

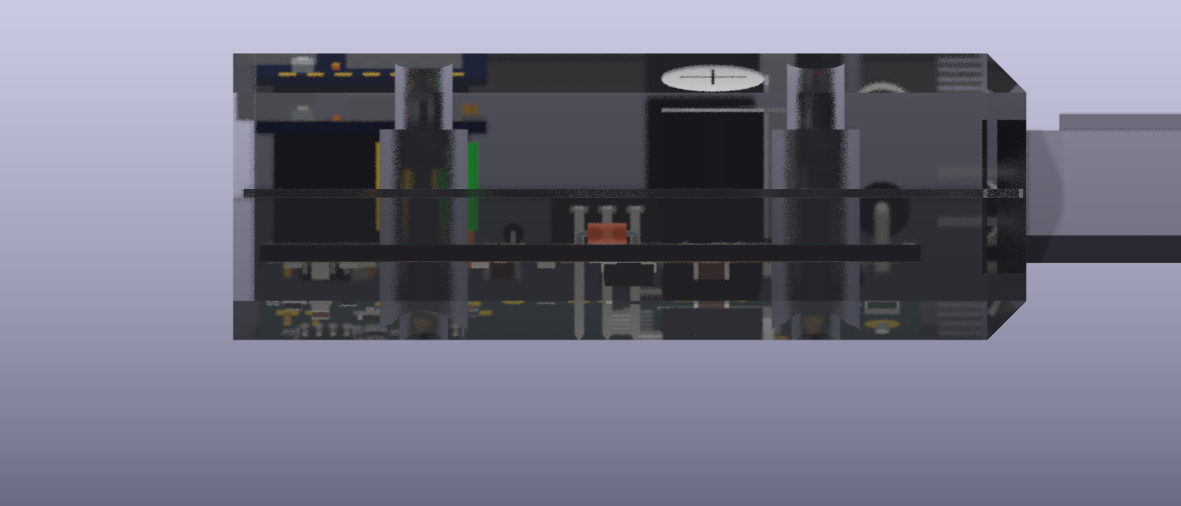
hardware/scaner_v1/case/board_in_case_side.png
