Aleksei327/ESP32-C5-OBD2-Scanner/hardware/scaner_v1/case/case_3d.png

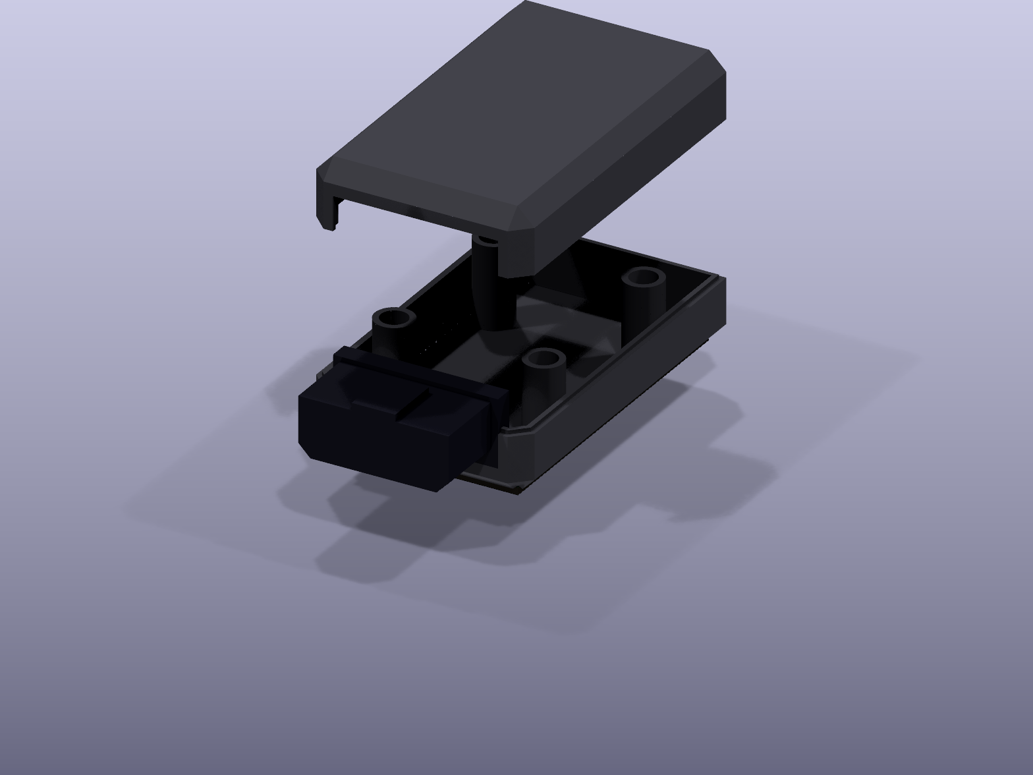
hardware/scaner_v1/case/case_3d.png
