Aleksei327/ESP32-C5-OBD2-Scanner/hardware/scaner_v1/case/case_assembly.step

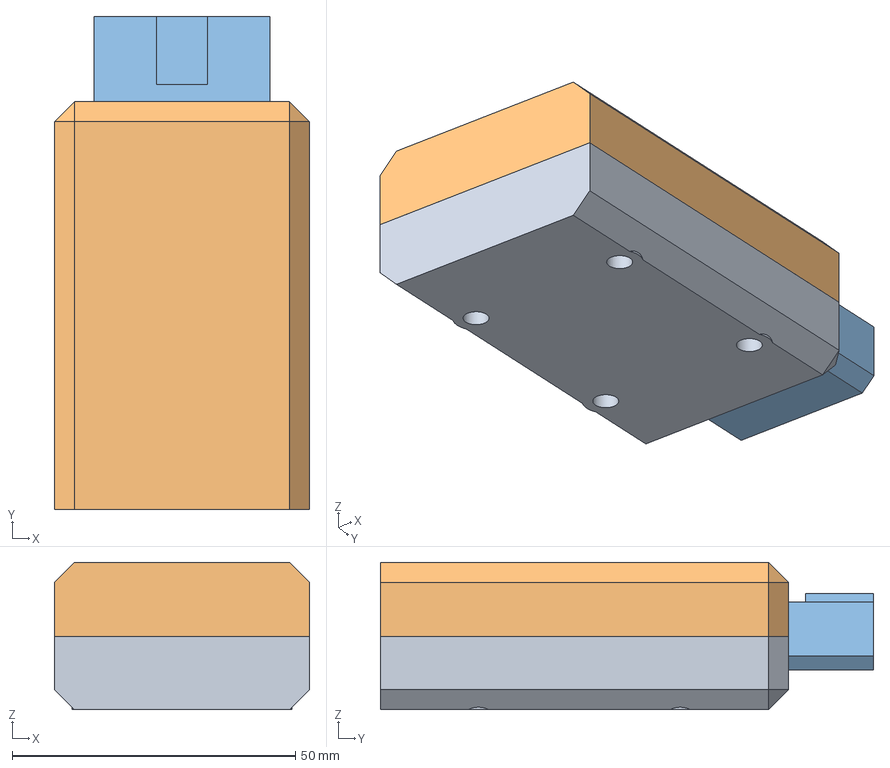
[picture p21: CAD file, 2026-11-02]
hardware/scaner_v1/case/case_assembly.step
45.0 x 87.0 x 26.0 mm
