Aleksei327/ESP32-C5-OBD2-Scanner/hardware/scaner_v1/case/case_lid.step

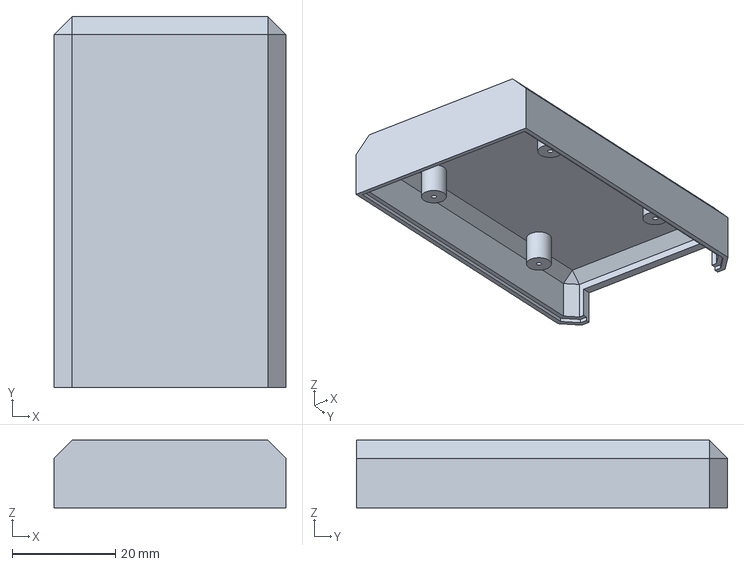
[picture p22: CAD file, 2026-11-02]
hardware/scaner_v1/case/case_lid.step
45.0 x 72.0 x 13.1 mm
