Aleksei327/ESP32-C5-OBD2-Scanner/hardware/scaner_v1/case/obd_plug.step

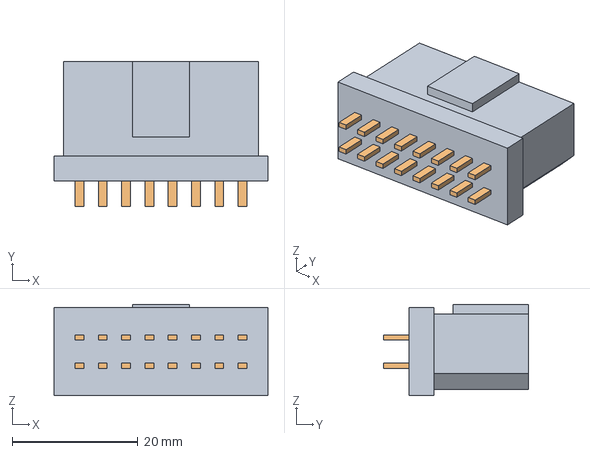
[picture p23: CAD file, 2026-11-02]
hardware/scaner_v1/case/obd_plug.step
34.0 x 23.0 x 14.5 mm
