Aleksei327/ESP32-C5-OBD2-Scanner/(list of files, cad)

Other CAD files:
hardware/scaner_v1/case/case.FCStd
