Aleksei327/ESP32-C5-OBD2-Scanner/hardware/scaner_v1/build/pcb_bottom_cu.pdf

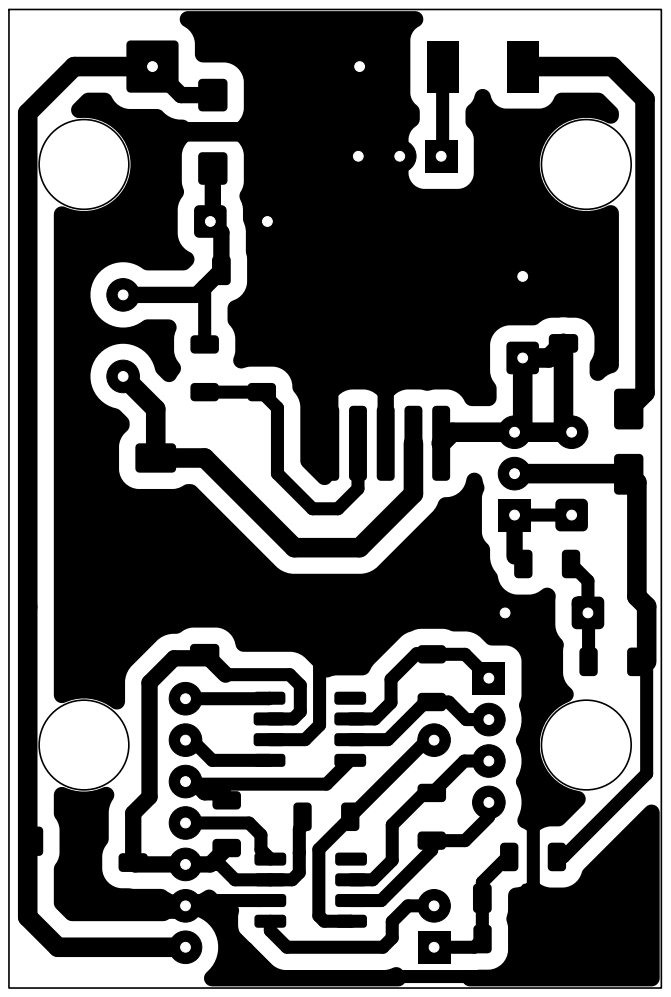
[picture p25: page 1]

Size: A4 | Rev:
KiCad E.D.A. 10.0.1 | Id: 1/1
