Aleksei327/ESP32-C5-OBD2-Scanner/hardware/scaner_v1/build/scaner_v1.pdf

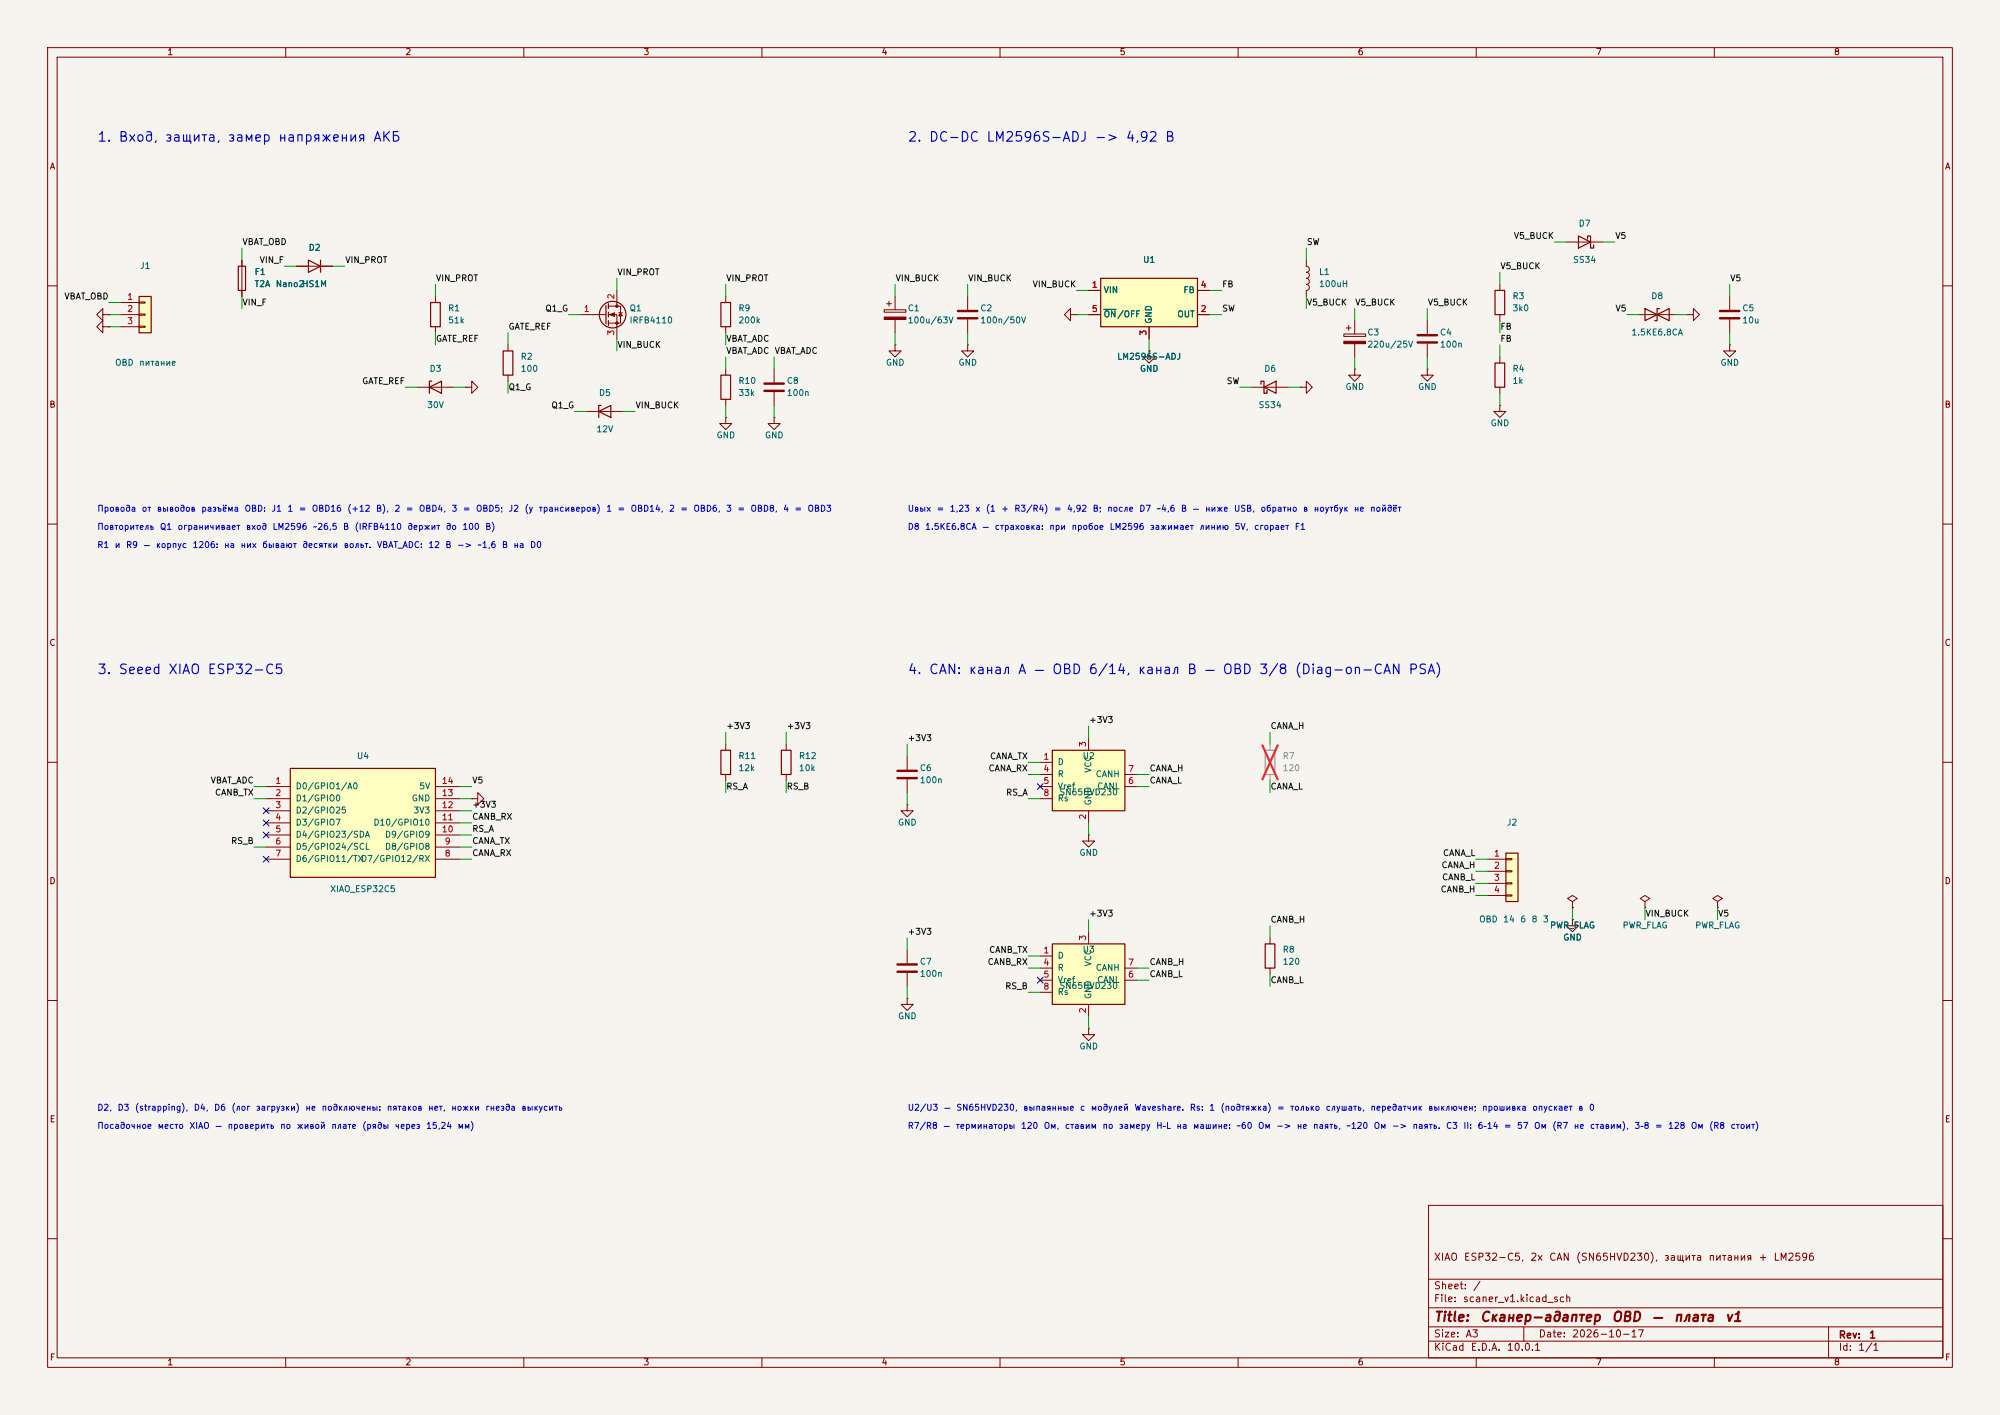
[picture p27: page 1]

1. Вход, защита, замер напряжения АКБ

Uвых = 1,23 x (1 + R3/R4) = 4,92 В; после D7 ~4,6 В — ниже USB, обратно в ноутбук не пойдёт D8 1.5KE6.8CA — страховка: при пробое LM2596 зажимает линию 5V, сгорает F1 3. Seeed XIAO ESP32-C5

Повторитель Q1 ограничивает вход LM2596 ~26,5 В (IRFB4110 держит до 100 В) Посадочное место XIAO — проверить по живой плате (ряды через 15,24 мм)

4. CAN: канал A — OBD 6/14, канал B — OBD 3/8 (Diag-on-CAN PSA)

D2, D3 (strapping), D4, D6 (лог загрузки) не подключены: пятаков нет, ножки гнезда выкусить

U2/U3 — SN65HVD230, выпаянные с модулей Waveshare. Rs: 1 (подтяжка) = только слушать, передатчик выключен; прошивка опускает в 0

XIAO ESP32-C5, 2x CAN (SN65HVD230), защита питания + LM2596

Sheet: /
File: scaner_v1.kicad_sch
Title: Сканер-адаптер OBD — плата v1

Size: A3 | Rev: 1 | F Date: 2026-10-17
KiCad E.D.A. 10.0.1 | Id: 1/1
