Aleksei327/ESP32-C5-OBD2-Scanner/hardware/scaner_v1/case/case_drawing.pdf

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

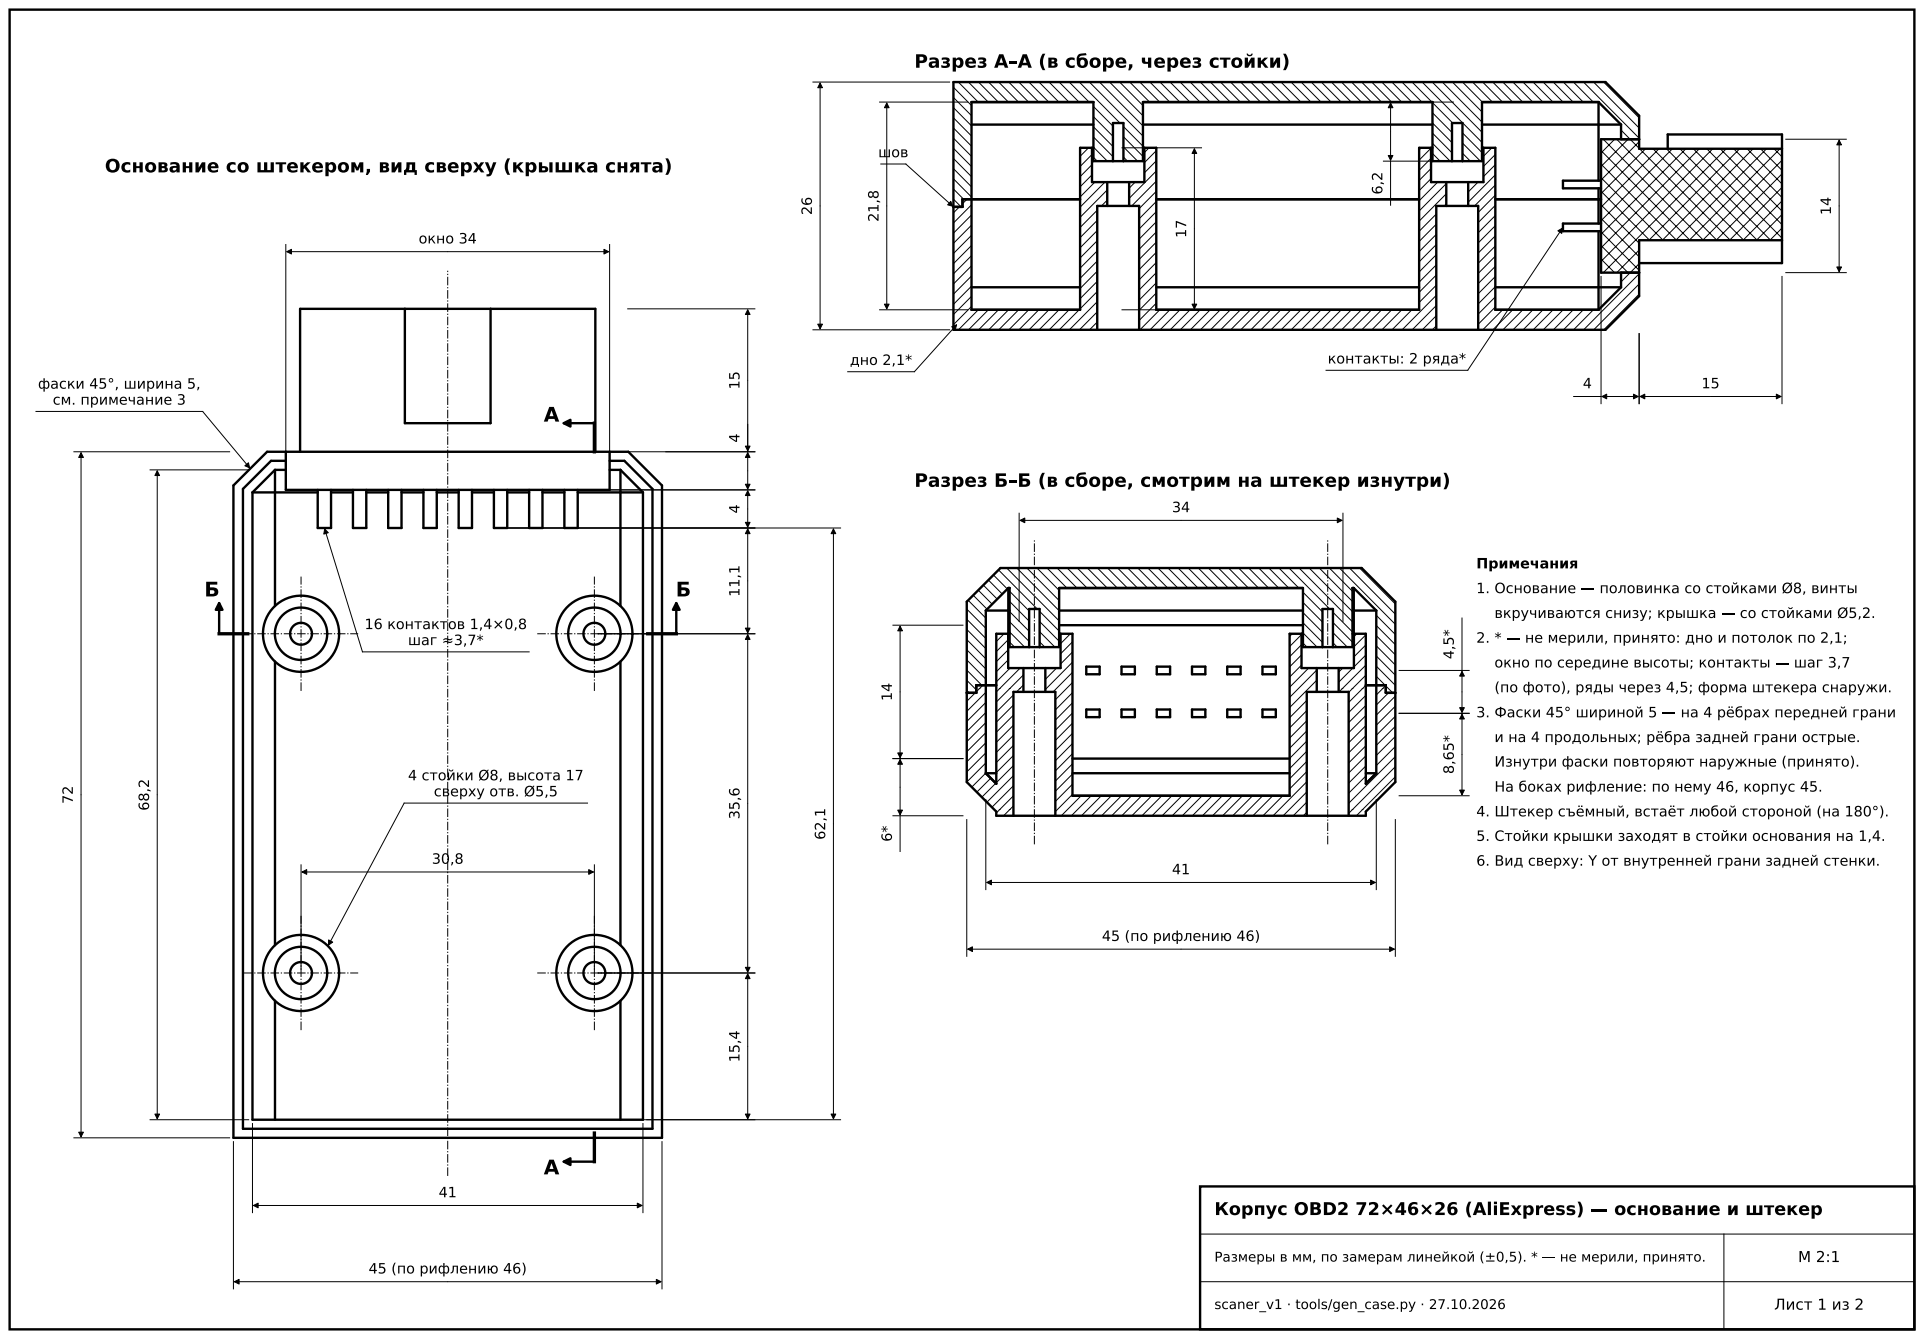
[picture p28: page 1]

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

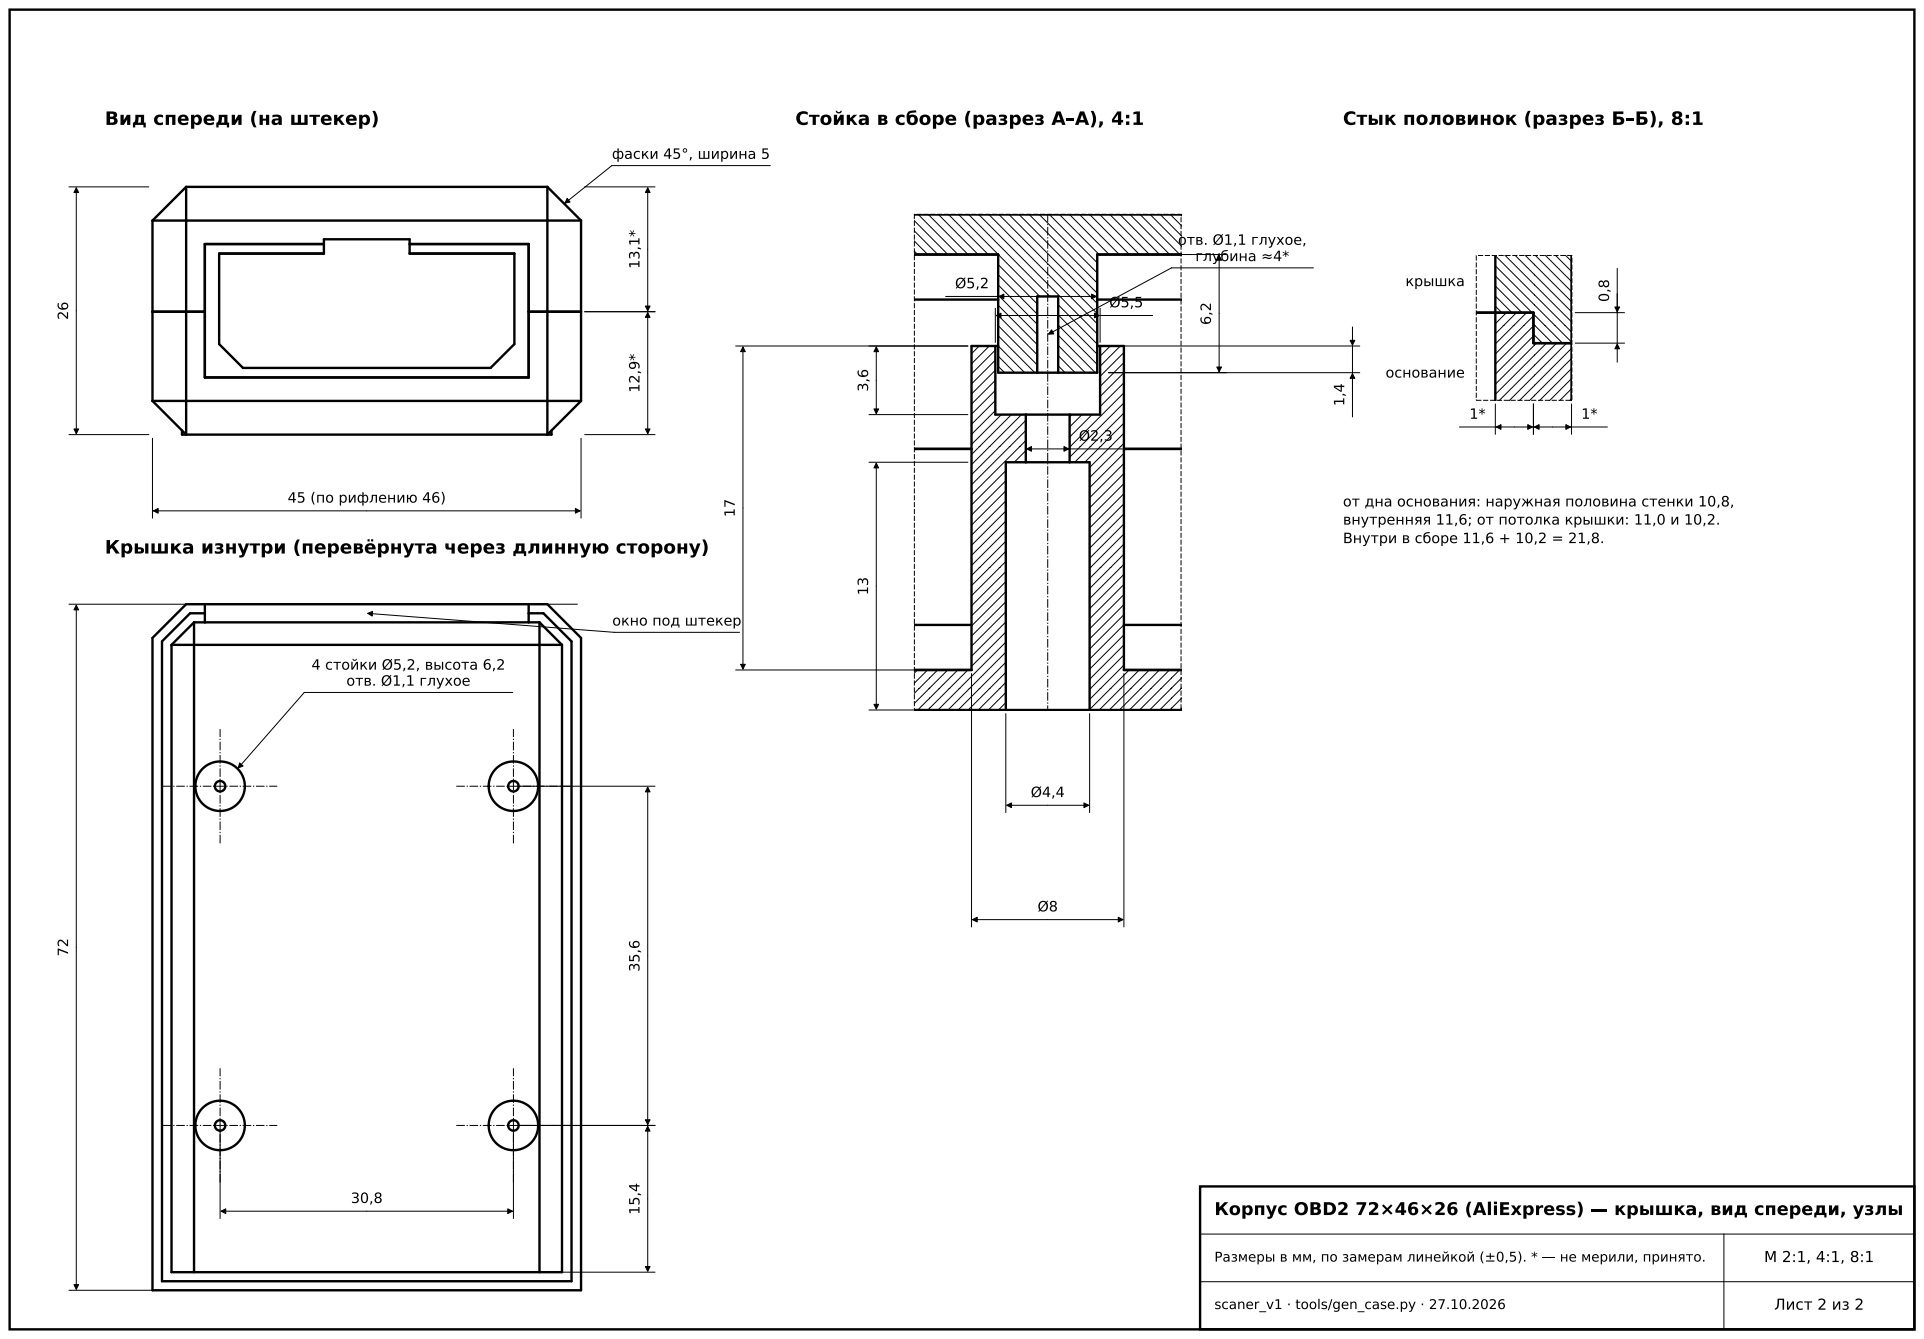
[picture p29: page 2]
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
