Aleksei327/ESP32-C5-OBD2-Scanner/hardware/scaner_v1/etch/1_NEGATIV_TONEROM_VNIZ.pdf

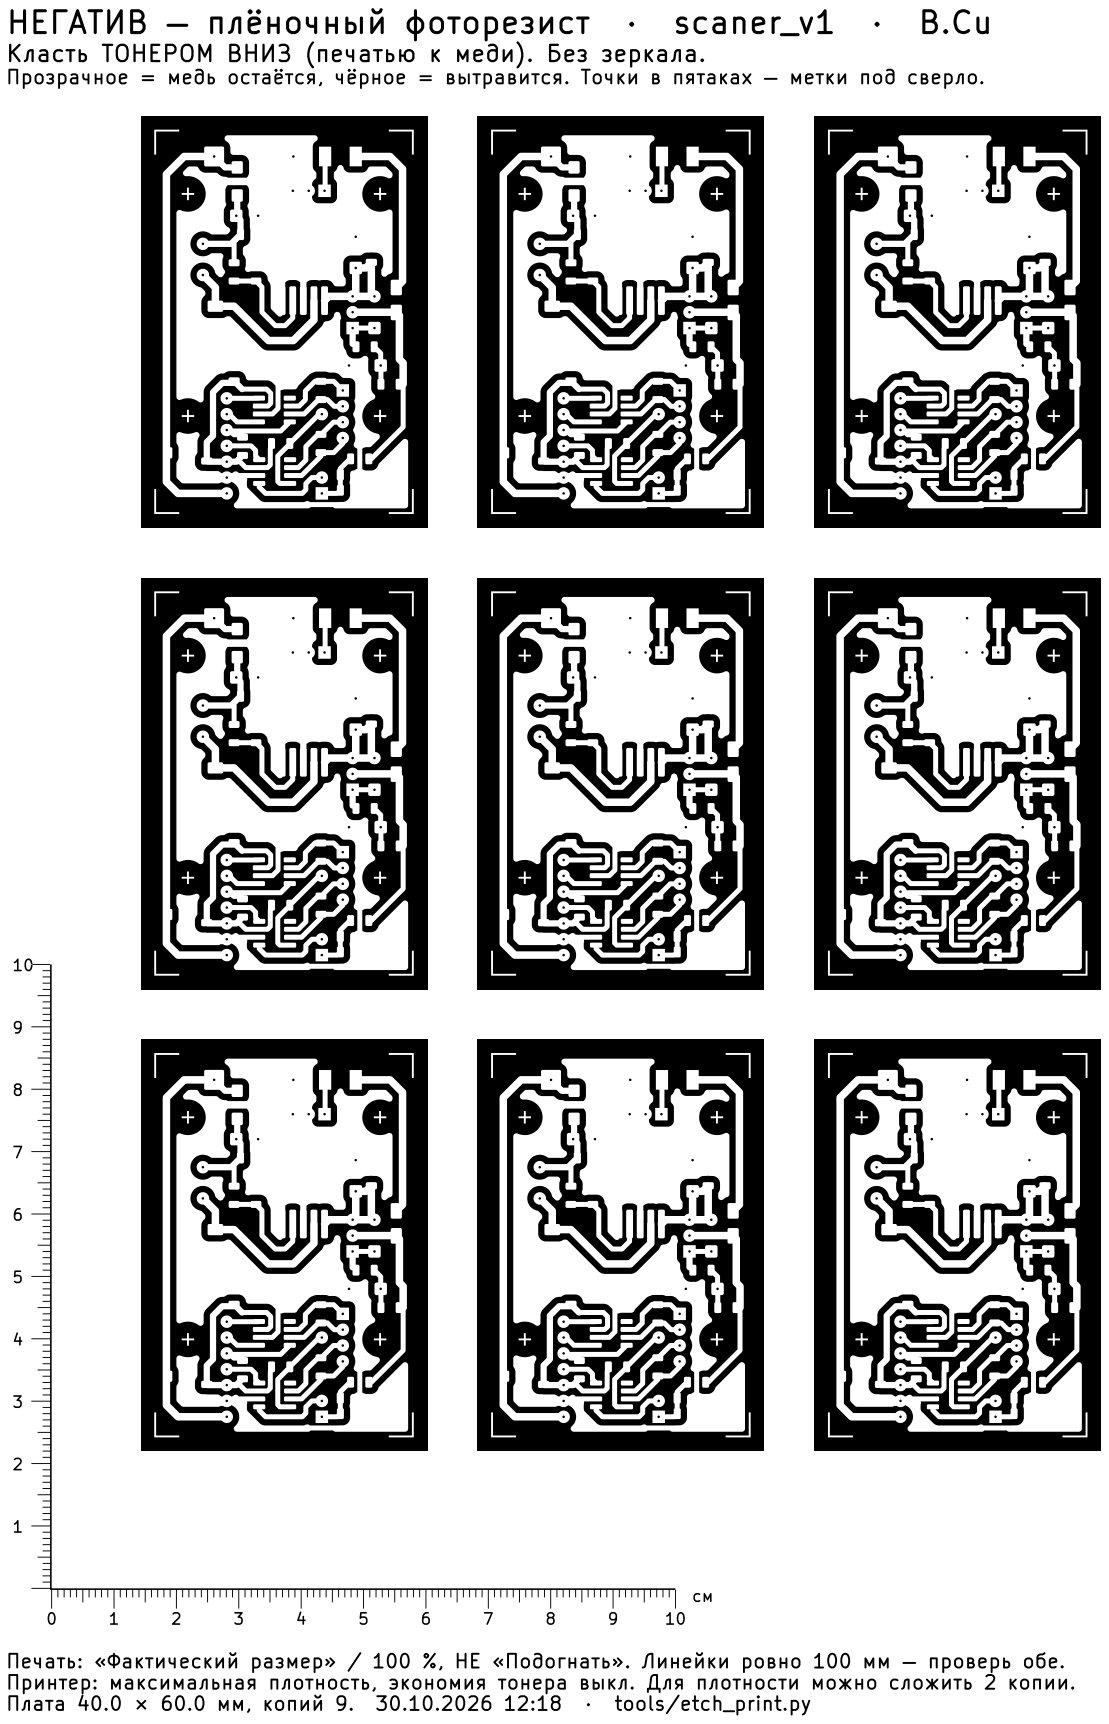
[picture p30: page 1]
