Aleksei327/ESP32-C5-OBD2-Scanner/hardware/scaner_v1/etch/1M_NEGATIV_TONEROM_VVERH.pdf

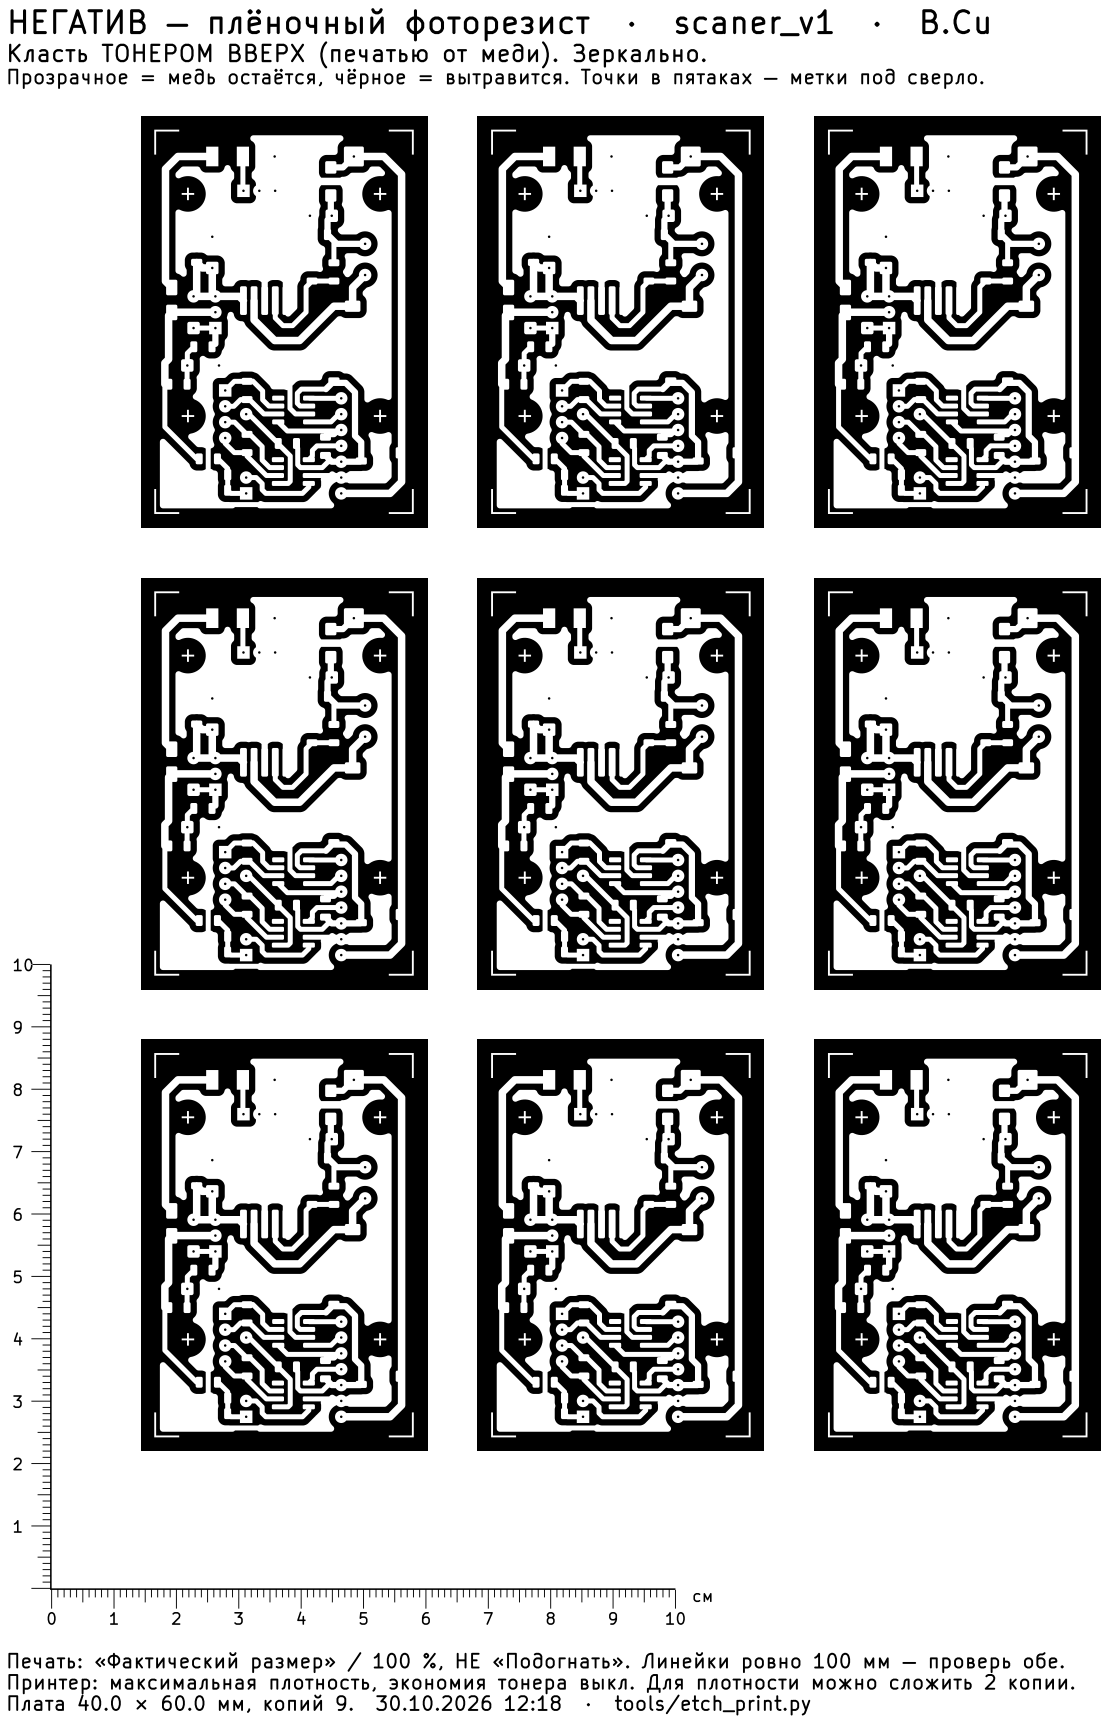
[picture p31: page 1]
