Aleksei327/ESP32-C5-OBD2-Scanner/hardware/scaner_v1/etch/2_POZITIV_LUT_TONEROM_VNIZ.pdf

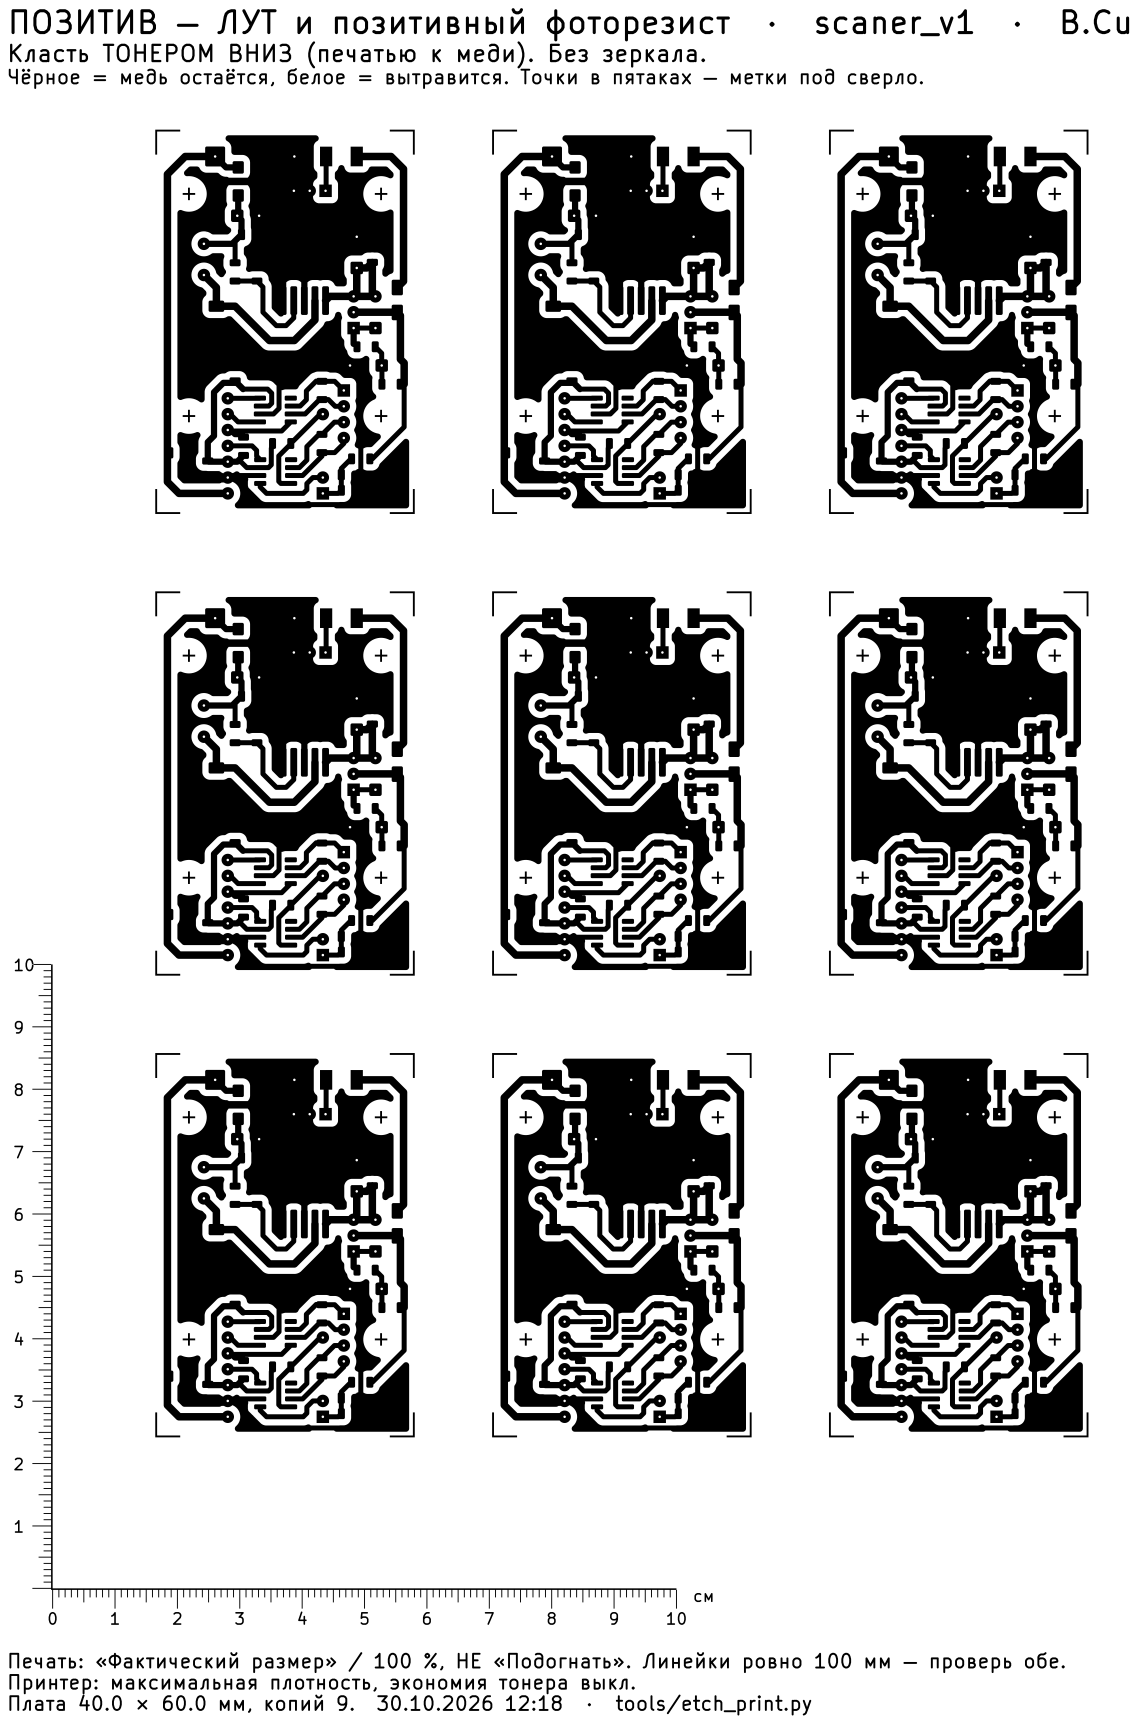
[picture p32: page 1]
