Aleksei327/ESP32-C5-OBD2-Scanner/hardware/scaner_v1/etch/2M_POZITIV_TONEROM_VVERH.pdf

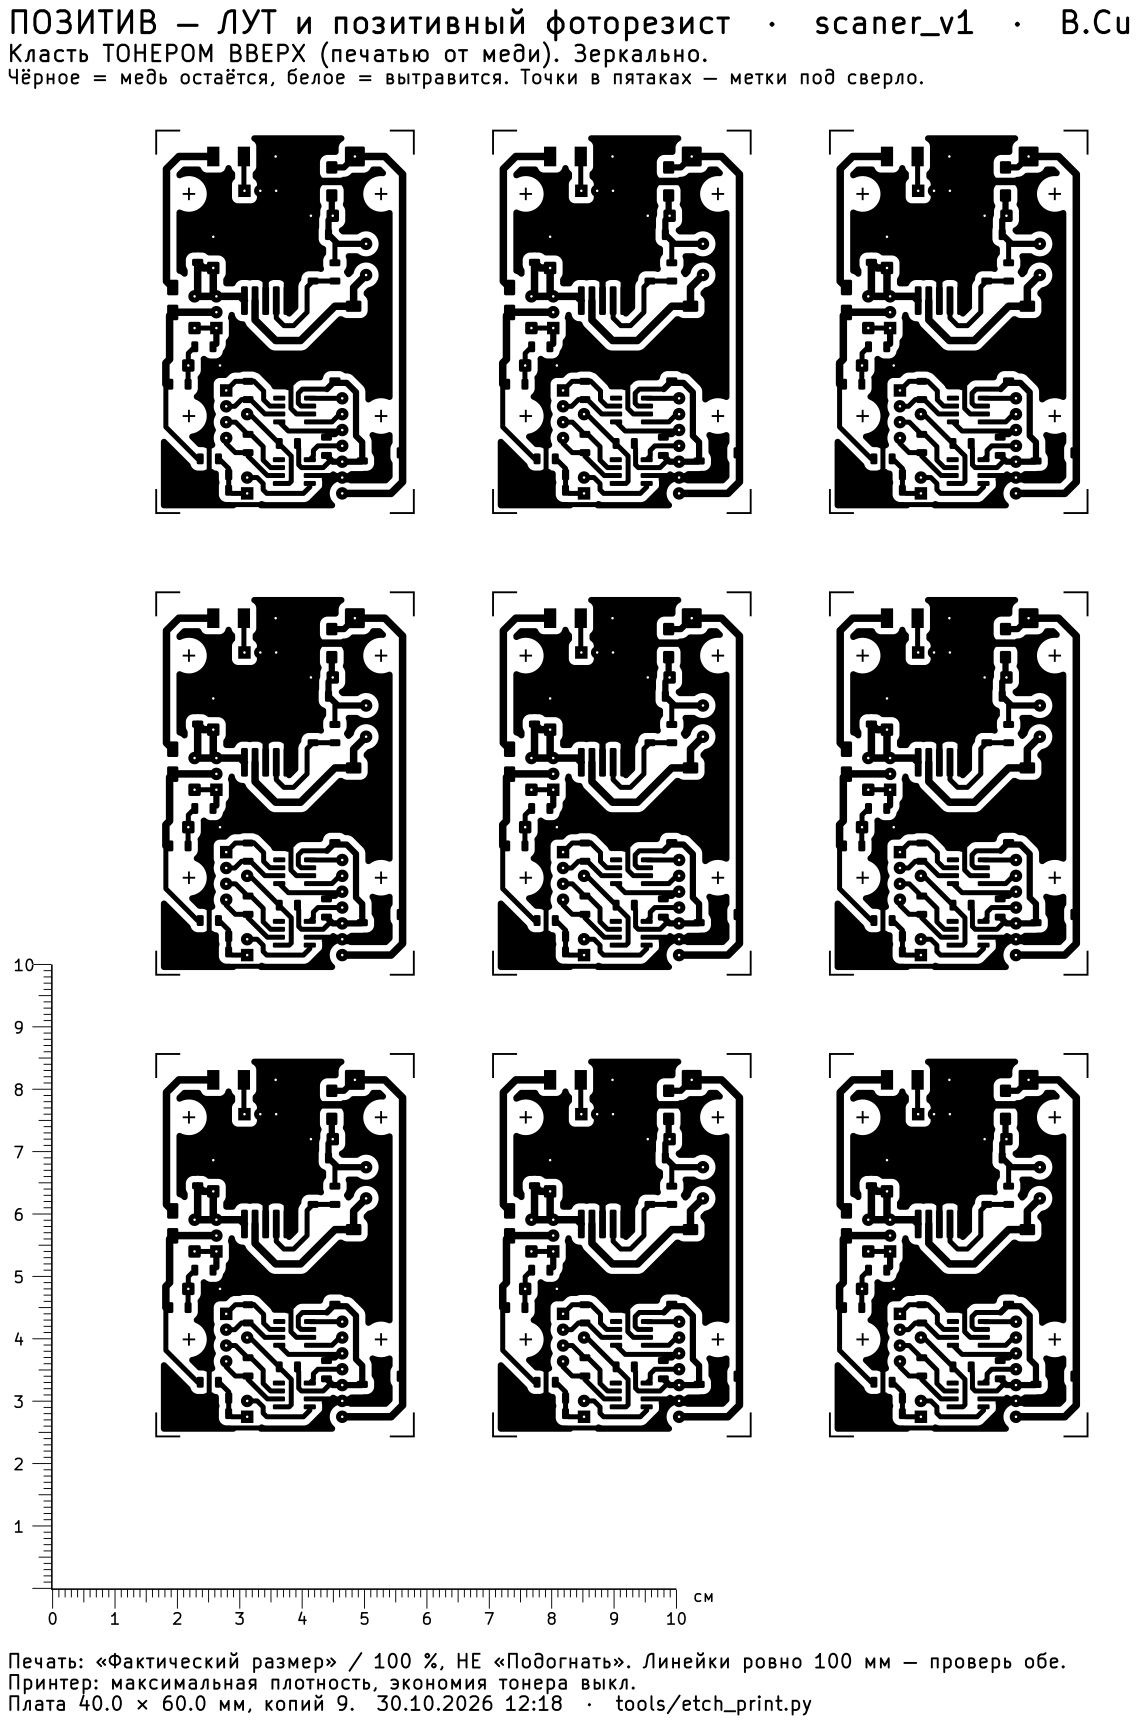
[picture p33: page 1]
