Aleksei327/ESP32-C5-OBD2-Scanner/hardware/scaner_v1/scaner_v1.kicad_pcb

## KiCad design hardware/scaner_v1/scaner_v1.kicad_pcb (2026-11-02)

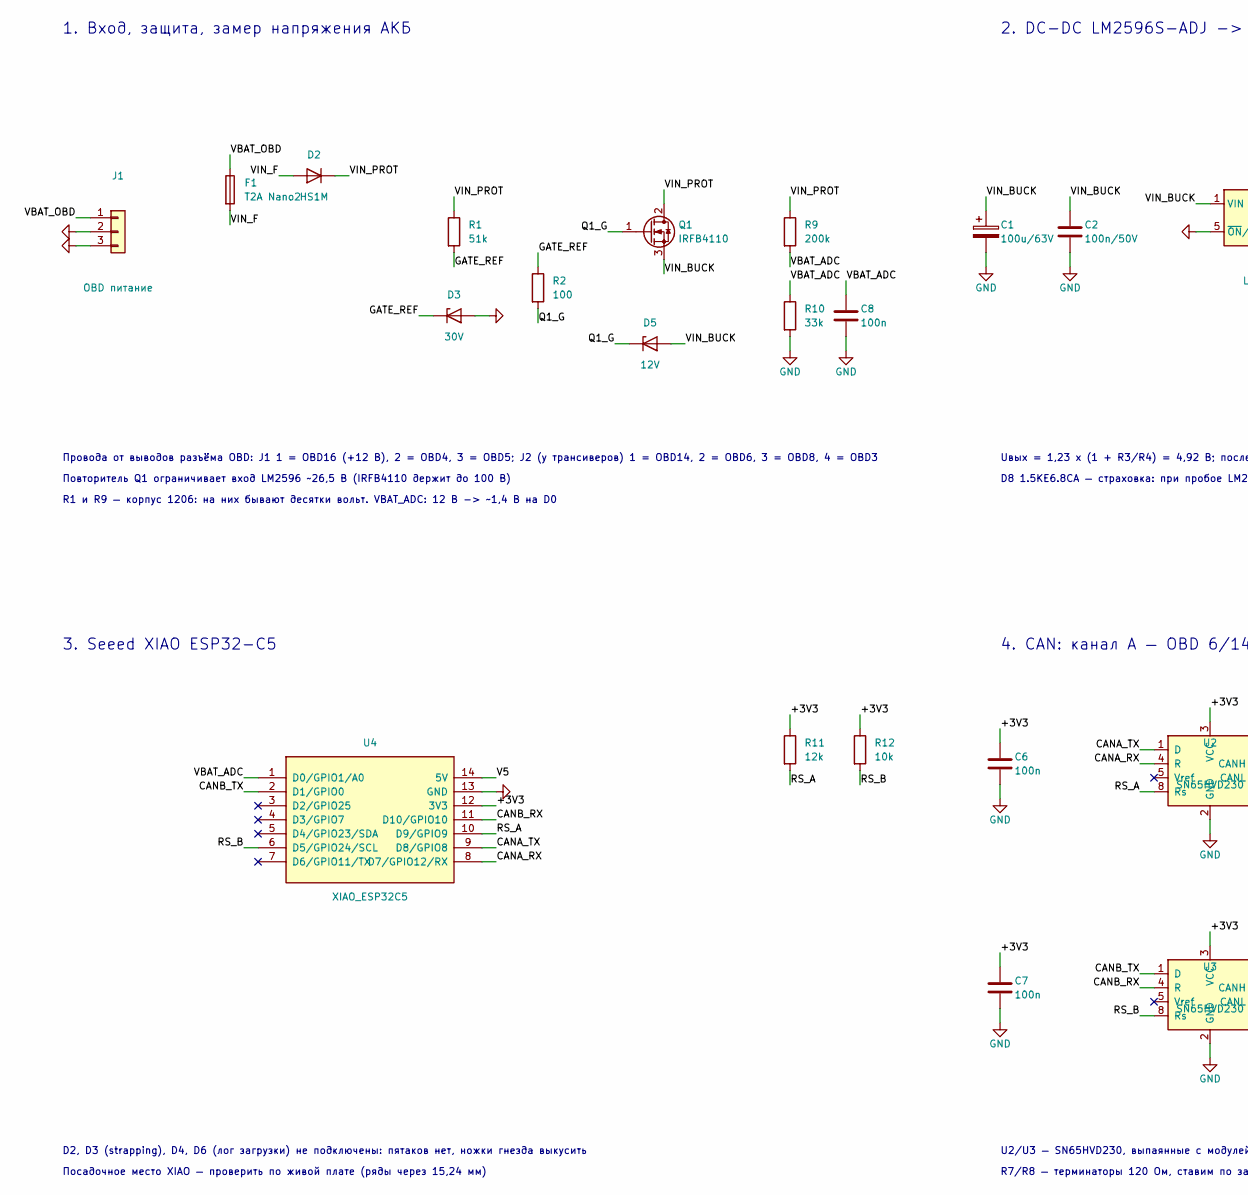
[picture p34: schematic scaner_v1.kicad_sch, Сканер-адаптер OBD — плата v1, part in row 1, column 1]

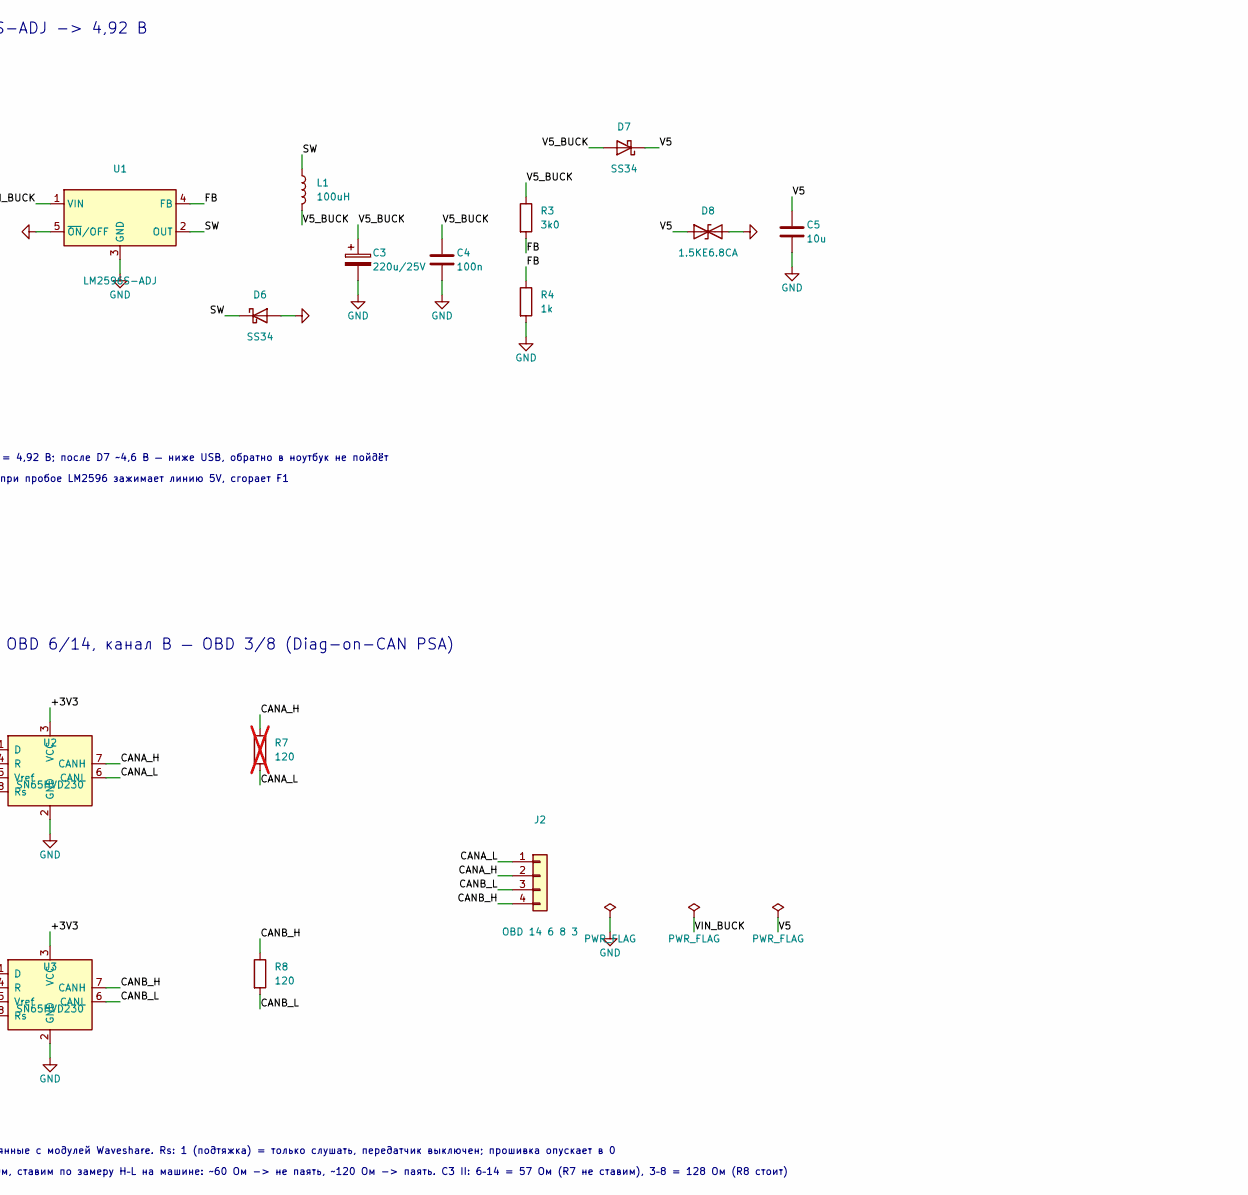
[picture p35: schematic scaner_v1.kicad_sch, Сканер-адаптер OBD — плата v1, part in row 1, column 2]

Parts:
C1: 100u/63V; CP_Radial_D10.0mm_P5.00mm
C2: 100n/50V; C_1206_3216Metric
C3: 220u/25V; CP_Radial_D8.0mm_P3.50mm
C4, C6, C7, C8: 100n; C_1206_3216Metric
C5: 10u; C_1206_3216Metric
D2: HS1M; D_SMA
D3: 30V; D_DO-35_P5.08mm_Horizontal
D5: 12V; D_DO-35_P5.08mm_Horizontal
D6, D7: SS34; D_SMA
D8: 1.5KE6.8CA; D_DO-201AD_P12.70mm_Horizontal
F1: T2A Nano2; Fuse_Littelfuse-NANO2-451_453
J1: OBD питание; PinHeader_1x03_P2.54mm_Vertical
J2: OBD 14 6 8 3; PinHeader_1x04_P2.54mm_Vertical
L1: 100uH; L_Radial_D10.0mm_P5.00mm_Fastron_07P
Q1: IRFB4110; TO-220-3_Horizontal_TabDown
R1: 51k; R_1206_3216Metric
R2: 100; R_1206_3216Metric
R3: 3k0; R_1206_3216Metric
R4: 1k; R_1206_3216Metric
R7: 120; R_1206_3216Metric; not fitted
R8: 120; R_1206_3216Metric
R9: 200k; R_1206_3216Metric
R10: 33k; R_1206_3216Metric
R11: 12k; R_1206_3216Metric
R12: 10k; R_1206_3216Metric
U1: LM2596S-ADJ; TO-263-5_TabPin3
U2, U3: SN65HVD230; SOIC-8_3.9x4.9mm_P1.27mm
U4: XIAO_ESP32C5; XIAO_ESP32C5_Socket

Connections:
/+3V3: C6.1, C7.1, R11.1, R12.1, U2.3 (VCC), U3.3 (VCC), U4.12 (3V3)
/CANA_H: J2.2, R7.1, U2.7 (CANH)
/CANA_L: J2.1, R7.2, U2.6 (CANL)
/CANA_RX: U2.4 (R), U4.8 (D7/GPIO12/RX)
/CANA_TX: U2.1 (D), U4.9 (D8/GPIO8)
/CANB_H: J2.4, R8.1, U3.7 (CANH)
/CANB_L: J2.3, R8.2, U3.6 (CANL)
/CANB_RX: U3.4 (R), U4.11 (D10/GPIO10)
/CANB_TX: U3.1 (D), U4.2 (D1/GPIO0)
/FB: R3.2, R4.1, U1.4 (FB)
/GATE_REF: D3.1 (K), R1.2, R2.1
/Q1_G: D5.1 (K), Q1.1 (G), R2.2
/RS_A: R11.2, U2.8 (Rs), U4.10 (D9/GPIO9)
/RS_B: R12.2, U3.8 (Rs), U4.6 (D5/GPIO24/SCL)
/SW: D6.1 (K), L1.1, U1.2 (OUT)
/V5: C5.1, D7.1 (K), D8.1 (A1), U4.14 (5V)
/V5_BUCK: C3.1, C4.1, D7.2 (A), L1.2, R3.1
/VBAT_ADC: C8.1, R9.2, R10.1, U4.1 (D0/GPIO1/A0)
/VBAT_OBD: F1.1, J1.1
/VIN_BUCK: C1.1, C2.1, D5.2 (A), Q1.3 (S), U1.1 (VIN)
/VIN_F: D2.2 (A), F1.2
/VIN_PROT: D2.1 (K), Q1.2 (D), R1.1, R9.1
GND: C1.2, C2.2, C3.2, C4.2, C5.2, C6.2, C7.2, C8.2, D3.2 (A), D6.2 (A), D8.2 (A2), J1.2, J1.3, R4.2, R10.2, U1.3 (GND), U1.5 (~ON/OFF), U2.2 (GND), U3.2 (GND), U4.13 (GND)

Notes on the sheet:
1. Вход, защита, замер напряжения АКБ
2. DC-DC LM2596S-ADJ -> 4,92 В
3. Seeed XIAO ESP32-C5
4. CAN: канал A — OBD 6/14, канал B — OBD 3/8 (Diag-on-CAN PSA)
Провода от выводов разъёма OBD: J1 1 = OBD16 (+12 В), 2 = OBD4, 3 = OBD5; J2 (у трансиверов) 1 = OBD14, 2 = OBD6, 3 = OBD8, 4 = OBD3
Повторитель Q1 ограничивает вход LM2596 ~26,5 В (IRFB4110 держит до 100 В)
R1 и R9 — корпус 1206: на них бывают десятки вольт. VBAT_ADC: 12 В -> ~1,4 В на D0
Uвых = 1,23 x (1 + R3/R4) = 4,92 В; после D7 ~4,6 В — ниже USB, обратно в ноутбук не пойдёт
D8 1.5KE6.8CA — страховка: при пробое LM2596 зажимает линию 5V, сгорает F1
D2, D3 (strapping), D4, D6 (лог загрузки) не подключены: пятаков нет, ножки гнезда выкусить
Посадочное место XIAO — проверить по живой плате (ряды через 15,24 мм)
U2/U3 — SN65HVD230, выпаянные с модулей Waveshare. Rs: 1 (подтяжка) = только слушать, передатчик выключен; прошивка опускает в 0
R7/R8 — терминаторы 120 Ом, ставим по замеру H–L на машине: ~60 Ом -> не паять, ~120 Ом -> паять. C3 II: 6–14 = 57 Ом (R7 не ставим), 3–8 = 128 Ом (R8 стоит)

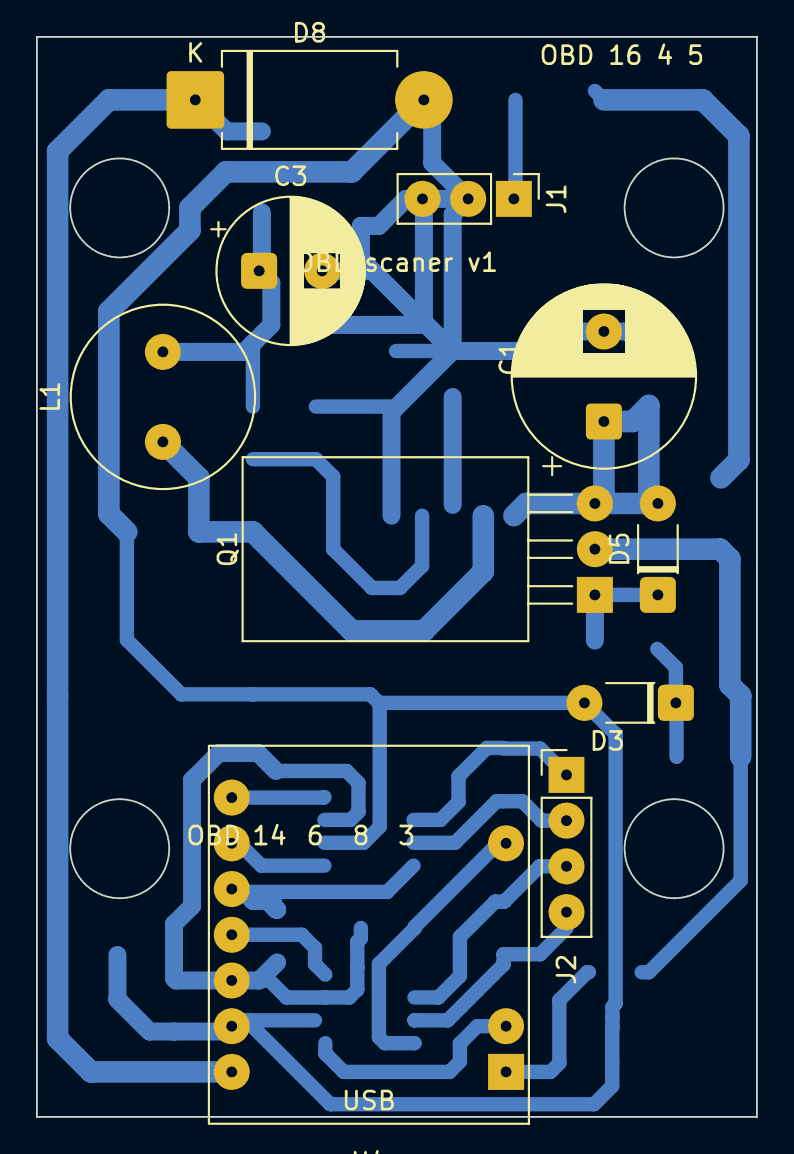
[picture p36: board scaner_v1.kicad_pcb from above]

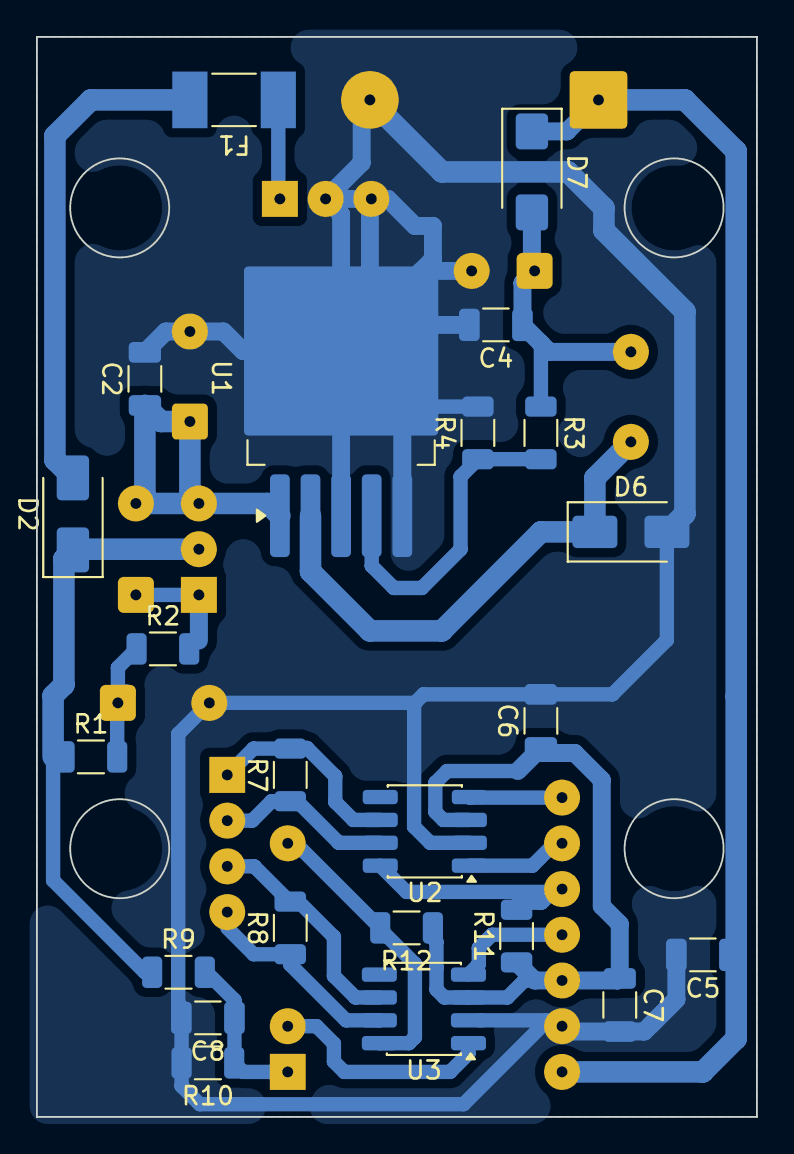
[picture p37: board scaner_v1.kicad_pcb from below]

Board: 2 copper layers, 40.0 x 60.0 mm, 34 parts (23 on the bottom side), 23 nets.

Other parts of the board:
CASE1: Корпус OBD2 72x46x26; Case_OBD2_72x46
