Aleksei327/ESP32-C5-OBD2-Scanner/hardware/scaner_v1/tools/routes.py

"""Ручная разводка платы v1: дорожки по нижней меди и перемычки сверху. Кладёт их tools/hand_route.py.

Точка — (x, y) в мм или 'REF.N' (центр площадки N детали REF).
TRACKS: (цепь, ширина мм, [точки]) — ломаная по нижней меди.
JUMPERS: (цепь, точка, точка) — проволочная перемычка сверху; на концах отверстие 0.6 под провод,
если конец не в отверстии выводной детали.
Земля дорожками почти не ведётся — это заливка; ниже только связки, которые заливка не достаёт.
Под дросселем L1 меди нет (запрет): к его площадкам подходим снаружи корпуса, по краю площадки.
"""

P = 1.2    # питание
SW_W = 1.0
S = 0.8    # сигналы
T = 0.6    # тесные места

TRACKS = [
    # ---- вход: OBD16 -> предохранитель -> HS1M -> VIN_PROT
    ('VBAT_OBD', P, [(118.2, 107.0), (123.2, 107.0)]),
    ('VBAT_OBD', P, ['J1.1', (120.0, 107.0)]),
    ('VIN_F', P, [(133.2, 107.0), (138.2, 107.0)]),
    ('VIN_F', P, [(137.6, 107.0), 'D2.2']),
    ('VIN_PROT', P, ['D2.1', (134.2, 110.6), (134.2, 120.8), (136.2, 122.8), (136.2, 128.46), 'Q1.2']),
    ('VIN_PROT', S, [(134.2, 120.8), 'JP1.1']),
    ('VIN_PROT', S, [(136.2, 128.46), (136.8, 129.06), 'R1.1']),
    ('VIN_PROT', S, ['R1.1', (138.7, 130.04), (138.7, 149.5), 'R9.1']),     # на делитель АКБ
    # ---- повторитель Q1
    ('VIN_BUCK', P, ['Q1.3', (131.3, 124.5), 'C1.1']),
    ('VIN_BUCK', S, ['C1.1', 'JP1.2']),
    ('VIN_BUCK', P, ['Q1.3', 'C2.1', (126.5, 126.3)]),
    ('VIN_BUCK', S, ['Q1.3', (133.2, 125.0), 'D5.2']),
    ('Q1_G', S, ['Q1.1', 'D5.1', 'R2.2']),
    ('GATE_REF', S, ['R1.2', (136.5, 133.6), 'D3.1']),
    ('GATE_REF', S, ['R2.1', (136.5, 136.46)]),
    ('ZMID', S, ['D3.2', 'D4.1']),
    # ---- LM2596
    ('SW', SW_W, ['U1.2', (125.0, 128.9), (125.0, 134.6), (109.2, 134.6), (109.2, 133.6)]),  # в L1.1 снизу
    ('FB', S, ['U1.4', (121.4, 129.3), (120.9, 129.8), 'R4.1', 'R3.2']),
    ('GND', S, ['R4.2', (119.2, 129.4), (119.7, 128.9)]),          # R4 и ON/OFF (5) — на землю
    ('GND', 1.0, [(123.1, 128.6), 'D6.2']),                          # диод SS34 — прямо к земле LM2596
    ('GND', 1.0, [(123.1, 126.0), (123.1, 120.0)]),                 # ножка 3 к теплоотводу
    ('GND', 1.0, ['C1.2', (128.4, 116.8)]),
    ('V5_BUCK', P, ['D7.2', (109.2, 110.4), (109.2, 120.3)]),       # сверху в L1.2, мимо C3
    ('V5_BUCK', P, [(109.2, 118.6), (115.6, 118.6)]),
    ('V5_BUCK', P, ['C4.1', (114.97, 118.6)]),
    ('V5_BUCK', S, [(115.6, 118.6), (116.6, 118.6), (116.6, 132.2), 'R3.1']),
    # земля питания <-> остальная: между ножками D7, вниз между 5V и V5_BUCK, слева мимо дросселя
    # (заливка с зазором 1 мм туда не пролезает) и полосой под линией SW до правого кармана с D4
    ('GND', S, [(107.0, 106.0), (107.0, 119.5), (102.75, 119.5), (102.75, 136.0), (127.5, 136.0)]),
    ('GND', S, [(119.7, 124.6), (119.7, 121.6)]),                   # ножка 5 (ON/OFF) к теплоотводу
    # ---- 5 В к XIAO (по левому краю, мимо крепёжных отверстий справа)
    ('V5', P, ['D7.1', 'D8.1']),
    ('V5', P, ['D7.1', (105.6, 111.0), (105.6, 116.4), (104.0, 118.0), (101.3, 118.0), (101.3, 141.5),
               (105.6, 145.8), (105.6, 165.5), (106.6, 166.5), 'U4.14']),
    ('V5', S, ['C5.1', (101.3, 140.0)]),
    # ---- напряжение АКБ -> D0 (по правому краю)
    ('VBAT_ADC', S, ['R9.2', (134.6, 150.8), (134.6, 160.0), (131.04, 161.8), 'R10.1', 'U4.1']),
    # ---- 3,3 В и земля трансиверов
    ('+3V3', S, ['U2.3', (115.86, 147.1), (112.4, 147.1), 'C6.1']),     # под корпусом U2
    ('+3V3', S, ['C6.1', (110.8, 149.0), (110.8, 161.42), 'U4.12']),
    ('+3V3', S, ['U4.12', 'R11.1', 'C7.1', (118.8, 162.3), (121.56, 162.3), 'U3.3']),
    ('+3V3', S, ['U3.3', (121.56, 158.0), (124.9, 158.0), 'R12.1']),    # под корпусом U3
    ('GND', S, ['U2.2', (117.14, 145.9), (112.6, 145.9), 'C6.2']),     # под корпусом U2
    ('GND', S, ['U3.2', (122.84, 164.47), 'C7.2', 'U4.13']),
    # ---- CAN A: J2.1 = OBD14, J2.2 = OBD6
    ('CANA_L', S, ['U2.6', (115.86, 143.0), 'J2.1']),
    ('CANA_H', S, ['U2.7', (117.14, 142.6), 'J2.2']),
    ('CANA_H', S, ['J2.2', 'R7.1']),
    ('CANA_RX', S, ['U2.4', (114.59, 150.2), (113.6, 151.0), 'U4.8']),
    ('CANA_TX', S, ['U2.1', (118.41, 151.2), (115.81, 153.8), 'U4.9']),
    ('RS_A', S, ['U2.8', (119.9, 144.03), (119.9, 152.5), (116.06, 156.34), 'U4.10']),
    ('RS_A', S, [(116.5, 156.34), 'R11.2']),
    # ---- CAN B (трансивер под XIAO): J2.3 = OBD8, J2.4 = OBD3
    ('CANB_L', S, ['U3.6', (121.56, 143.0), 'J2.3']),
    ('CANB_H', S, ['U3.7', (122.84, 143.0), 'J2.4']),
    ('CANB_H', S, ['J2.4', 'R8.1']),
    ('CANB_RX', S, ['U3.4', (119.5, 159.9), (115.0, 159.9), (113.98, 158.88), 'U4.11']),
    ('CANB_TX', S, ['U3.1', (124.11, 162.4), (125.67, 163.96), 'U4.2']),
    ('RS_B', S, ['U3.8', (124.11, 153.8), 'U4.6']),
    ('RS_B', S, [(125.825, 153.8), 'R12.2']),
]

JUMPERS = []
