Aleksei327/ESP32-C5-OBD2-Scanner/(commit log)

2026-10-17 Initial project: docs, KiCad schematic and draft PCB
    DIY dual-CAN OBD2 adapter on Seeed XIAO ESP32-C5.
    - Russian documentation: power input protection, LM2596 DC-DC,
    SN65HVD230 transceivers, XIAO pinout, parts list
    - KiCad 10 schematic (ERC clean, netlist verified against intent)
    - Draft placement of a 41 x 58 mm single-sided board for an
    OBD2 enclosure (not routed yet)
    - Schematic/PCB generator and netlist check scripts
2026-10-17 Add self-test firmware for XIAO ESP32-C5 (ESP-IDF 6.1)
    - Two TWAI channels (OBD 6/14 and PSA Diag-on-CAN 3/8) at 500 kbit/s
    - Transceiver Rs pins driven high at boot: hardware listen-only
    - USB console commands: selftest (A<->B loopback), listen, vbat, status
    - Battery voltage via 220k/33k divider on D0
    - Builds cleanly; project must live on an ASCII-only path
2026-10-17 PCB: 40 x 70 mm outline, holes 35 x 40 mm
    Re-placed the draft layout for the measured enclosure size.
    DRC clean except silkscreen; still unrouted.
2026-10-18 Add adapter simulator and WebSocket protocol description
    c3_sim.py pretends to be the adapter with a Citroen C3 II attached
    (made-up VIN and DIDs), test_client.py checks the simulator or the
    real adapter. Protocol documented in Russian and English.
2026-10-18 Board v1: single-sided hand routing, 4-pin CAN connector, 3D models
    - Tracks on bottom copper only, no wire jumpers; routes kept in
    tools/routes.py and laid by tools/hand_route.py, DRC clean
    - THT pads 2.0 mm, 0.6 mm drills, SOIC pads 0.8 mm, solid GND pour
    with 1 mm clearance, no copper under the inductor
    - J2 and J3 merged into one 4-pin CAN connector
    - 12x12 inductor footprint with wide pads; VRML models for the XIAO
    on sockets, inductor, fuse holder and wire leads
    - Firmware: new CAN pin map, TX held high and Rs released only after
    the controller starts (no pull-ups on the board)
2026-10-18 Add Flutter app: read-only PSA/OBD-II diagnostics, RU/EN
    ECU scan and discovery, identification, fault codes with freeze
    frames (read and clear), live data, OBD-II gauges with CSV logging,
    CAN bus monitor, PDF report, garage of cars by VIN. Talks to the
    adapter over WebSocket. Generated l10n code is not committed.
2026-10-18 Docs in English and Russian; English main README
    - README.md is now the English main page, README.ru.md the Russian one
    - English translations of all documents in DOCS/en/, 3D renders in
    DOCS/images/, READMEs for app, sim, firmware and hardware
    - Russian docs updated for the routed board and the new pin map
    - NOTICE: source code is covered too; third-party credits
2026-10-19 App: PSA KWP2000, knowledge base from PSA-RE, Russian fault texts
    - Talk to PSA ECUs over KWP2000 on CAN (10 C0 / 81, 21 xx, 17 FF 00,
    14 FF 00) as well as UDS; detect protocol per ECU and ECU model by
    part number. Still read-only plus fault clearing.
    - Knowledge base generated by app/tool/build_kb.py from pinned PSA-RE
    (Apache-2.0): 25 ECUs, 55 models, 1047 data records, fault texts.
    - Fault texts missing in PSA-RE: ludwig-v/arduino-psa-diag lists in a
    separate GPL-3.0 file (c3_ii_dtc_gpl.json), generic SAE J2012 texts
    from OBD Codes List for the standard ranges only, marked in the UI.
    - All texts translated to Russian (tool/kb_ru.json, SAE texts composed
    by tool/sae_ru.py).
    - G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
2026-10-22 Adapter firmware: Wi-Fi access point and WebSocket protocol
    - Access point SCANER-C5-XXXX with a random WPA2 password kept in NVS
    (console: wifi, wifi pass).
    - WebSocket server ws://192.168.4.1:81/ws speaking the same protocol
    as the simulator: hello, vbat, bus.open/close, isotp.req (incl.
    rx "*"), tester.start/stop, monitor.start/stop, vbat/frames events.
    - ISO-TP per bus with a command queue: bus A padded to 8 bytes,
    bus B unpadded with flow control 30 00 05 as PSA tools do;
    response pending (7F xx 78) handled in the adapter.
    - Buses are closed after power-up and again when the app disconnects.
    - Tested with the phone app over Wi-Fi (no transceivers fitted yet).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
2026-10-22 App: reach the adapter over Wi-Fi with mobile data on; remote assistant
    - Before connecting, the app binds itself to the Wi-Fi network that
    holds the adapter's address (NetBridge.kt), so it reaches
    192.168.4.1 while internet stays on mobile data.
    - Remote assistant (Settings): the phone bridges the adapter (Wi-Fi)
    and a relay on a home computer (mobile internet, Cloudflare tunnel),
    so the computer can read the car in a car park. Off until the user
    pastes the relay address and taps Start; a green bar and a
    foreground-service notification show while it runs, because Android
    blocks background network access otherwise.
    - remote/relay.py: relay with a per-run key and a cloudflared q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
2026-11-02 KiCad tool: print copper for home etching
    KiCad's print dialog cannot place a negative, mirrored, 1:1 copy of one
    copper layer on a sheet, so the board is printed with our own tool:
    - etch_print.py: copper to polygons, sheet layout, own PDF writer; the
    CLI writes negative/positive, toner-down/up variants into etch/.
    - etch_printer.py: 1:1 printing through Windows GDI and per-printer
    profiles, including a "film, maximum quality" preset.
    - etch_window.py: A4 preview with draggable copies and a KiCad action
    plugin; --pack builds etch_print_kicad_plugin.zip for the Plugin and
    Content Manager.
    - etch/: the four PDFs for board v1.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
2026-11-02 Board v1 as built: 40x60 for the OBD2 enclosure, fitted values
    - Board re-placed and hand-routed at 40 x 60 mm to fit the enclosure;
    the enclosure is modelled (tools/gen_case.py, case/: STEP, drawings,
    KiCad layer with the posts and plug pins).
    - Parts as fitted: through-hole L1 100 uH, 10x12.3 / 8x12.3 electrolytics,
    DO-35 zeners, R1 51k, R9 200k, R11 12k; the tapped 12x12 inductor and
    the 5x20 fuse holder footprints are gone.
    - Terminators decided by measurement on the C3 II: 6-14 = 57 ohm (both
    present, R7 left out), 3-8 = 128 ohm (BSI end only, R8 fitted).
    - Docs updated with the fitted values, the ADC divider and the results.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
2026-11-02 Firmware: 200k battery divider as fitted; self-test wording
    - VBAT_DIVIDER follows the fitted R9 = 200k (was 220k). Checked at
    15.08 V on pin 16: the adapter reads 15.03 V.
    - The self-test now asks for one 120 ohm resistor across H and L, since
    the board has no terminator jumpers.
2026-11-02 Remote: full read-only car scan, short relay key, HTTP/2 tunnel
    - remote/scan.py walks every ECU in the knowledge base: finds who
    answers, recognises the model by part number, reads fault codes with
    texts and every data record, then OBD-II on bus A. Results go to
    scans/<date_time>/ (report.md, scan.json); scans/ is git-ignored
    because it holds the car's VIN. Only read services can be sent.
    - The relay key is 8 characters without 0/o and 1/l/i, so it can be
    typed on a phone.
    - cloudflared runs over HTTP/2: QUIC dropped every few seconds on the
    home network.
2026-11-02 README: status after the first car scan
    Board v1 is built and working; the first scan of the C3 II found ten
    ECUs, with a Valeo V34 engine ECU. Board size is 40 x 60 mm; the
    terminator measurements are noted.
2026-11-02 App 0.1.3: PSA fault codes as kind + number
    On KWP a PSA fault code is two bytes: the first hex digit is the kind of
    fault (short to battery, open circuit...), the other three the number in
    the ECU's range. The app and remote/scan.py now show the raw PSA code next
    to the SAE-style one and take texts from a local PSA code list when it is
    present; for a number that is not listed they still name the ECU range and
    the kind of fault.
    The list itself comes from PSA's diagnostic code document, which may not
    be reproduced: app/tool/build_psa_codes.py builds it from your own copy
    into app/assets/kb/psa_codes.json, git-ignored like its translations.
    A clean clone builds and works without it.
    Co-Auth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
2026-11-02 Docs: 3D views, copper and PDFs of board v1 as built
    The pictures and PDF exports were still from the 18 October layout. Re-rendered from the hand-placed 40 x 60 board (case hidden for the bare-board views), board-in-case views redone, schematic note fixed to ~1.6 V at D0 for the 200k/33k divider.
2026-11-02 README: app screenshots (simulator, English)
    Six screens of app 0.1.3 next to the board picture: car, auto scan, engine live data, gauges and settings in the dark theme, bus monitor. Taken against sim/ and said so, cropped above the car-photo strip.
2026-11-02 App 0.1.4: saved scans, offline garage, PSA codes in RU and EN
    Scans are now kept on the phone, the last 10 per car, raw codes only:
    fault texts are looked up when shown. The Modules tab shows the latest
    scan (or one from the history) and never starts a scan by itself; a new
    auto scan comes from its button, and a single module can be rescanned
    from its own screen. Rescanning a module or clearing its faults adds a
    history entry, so the state before and after stays visible. Scans where
    no module answered are not saved.
    Without the adapter the garage and saved scans still open; live data,
    gauges and the bus monitor ask to connect. Any car can be deleted, the
    last one too, or all at once; an em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
2026-11-04 README: working status, photos of the scanner as built
    The status now says what works and was tested on the car (board, firmware, app 0.1.5, remote scan, simulator) instead of the bring-up notes, with photos of the scanner in its OBD2 enclosure and of the etched board from the copper side (resized, metadata stripped). Board docs: 40 x 60 mm as built and the real hole positions (four 5.5 mm holes, 30.8 x 35.6 mm, first pair 9.55 mm from the connector end) instead of the old 40 x 70 draft.
